ZjGaothu/Electronic-design/readme.md

# 环境舒适度综合测量仪

> 作者: 吴文绪 高子靖
> 
> 日期：2019年7月14日
