ZjGaothu/Electronic-design/miscellaneous/template/log_template.tex

\documentclass[a4paper, 11pt]{article} %option para: draft mode not insert figure, give a faster preview
\usepackage[UTF8]{ctex} %for chinese
\usepackage{amsmath}    %for math
\usepackage{geometry}   %for page setting
\usepackage{graphicx}   % for insert graph
\usepackage{color}    %for link and code color
\usepackage{float}    %for graph table in the follow word
\usepackage[colorlinks,linkcolor=blue,anchorcolor=blue,citecolor=green]{hyperref} %for a linked ref

\setlength{\parindent}{2em} % maybe not use delete it ?
\geometry{left=3.0cm, right=3.0cm, top=3.0cm, bottom=3.0cm}

\graphicspath{{figure/}}

%%%%%%%%%%%%%%%%%%%%%%%%%%%%%%%%%%%%%%%%%%%%%%%%%%%%%%%%%%%%%%%%%%%%%%%%%%%%%%%%%%%%%%%%%%%%%%
%%%%             optional package default in comment to improve compile speed            %%%%

% \usepackage{physics}    %for a readable formulation

% \usepackage[all]{hypcap} % use to jump to the top of figure/table rather than merely caption
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

% \usepackage{wrapfig}  % for picutre on the paragraph right, cannot work with chinese par in pdflatex

% % \usepackage{fontspec} % for other font family

% \usepackage{multirow} %for group row in a table

% % Threeparttable
% \usepackage{threeparttable}
% \usepackage{booktabs}

% % drawing script tikz and Circuitlib 
% \usepackage{tikz}
% \usetikzlibrary{circuits.ee.IEC}
% \usetikzlibrary{positioning}

% \usepackage[american]{circuitikz}

%%%%%%%%%%%%%%%%%%%%%%%%%%%%%%%%%%%%%%%%%%%%%%%%%%%%%%%%%%%%%%%%%%%%%%%%%%%%%%%%%%%%%%%
%%%%%                         new recommand setting area                           %%%%

% % Count those in subsection
% \makeatletter
% \@addtoreset{equation}{subsection}
% \@addtoreset{figure}{subsection}
% \@addtoreset{table}{subsection}
% \makeatother
% \renewcommand {\thefigure} {\thesubsection{}.\arabic{figure}}
% \renewcommand {\thetable} {\thesubsection{}.\arabic{table}}
% \renewcommand {\theequation} {\thesubsection{}.\arabic{equation}}

% \newcommand{\parallelsum}{\mathbin{\!/\mkern-5mu/\!}} % parallesum for resistor
% \newcommand{\upcite}[1]{\textsuperscript{\textsuperscript{\cite{#1}}}}

%%%%%%%%%%%%%%%%%%%%%%%%%%%%%%%%%%%%%%%%%%%%%%%%%%%%%%%%%%%%%%%%%%%%%%%%%%%%%%%%%%%%%%
%%%%%%%%%%%%%%%%%%%%%%%%              for a dairy box%          %%%%%%%%%%%%%%%%%%%%%%

%%%%%%%%%%%%%%%%%%%%%%%%%%%%%%%%%%%%%%%%%%%%%%%%%%%%%%%%%%%%%%%%%%%%%%%%%%%%%%%%%%%%%%%
%%%%%                         introduction section area                           %%%%

\usepackage{xcolor}
\usepackage{framed}

\newlength\sidebar
 \newlength\envrule
 \newlength\envborder
 \setlength\sidebar{1.5mm}
 \setlength\envrule{0.4pt}
 \setlength\envborder{2mm}

\makeatletter
 \long\def\fboxs#1{%
   \leavevmode
   \setbox\@tempboxa\hbox{%
     \color@begingroup
       \kern\fboxsep{#1}\kern\fboxsep
     \color@endgroup}%
   \@frames@x\relax}
 \def\frameboxs{%
   \@ifnextchar(%)
     \@framepicbox{\@ifnextchar[\@frameboxs\fboxs}}
 \def\@frameboxs[#1]{%
   \@ifnextchar[%]
     {\@iframeboxs[#1]}%
     {\@iframeboxs[#1][c]}}
 \long\def\@iframeboxs[#1][#2]#3{%
   \leavevmode
   \@begin@tempboxa\hbox{#3}%
     \setlength\@tempdima{#1}%
     \setbox\@tempboxa\hb@xt@\@tempdima
          {\kern\fboxsep\csname bm@#2\endcsname\kern\fboxsep}%
     \@frames@x{\kern-\fboxrule}%
   \@end@tempboxa}
 \def\@frames@x#1{%
   \@tempdima\fboxrule
   \advance\@tempdima\fboxsep
   \advance\@tempdima\dp\@tempboxa
   \hbox{%
     \lower\@tempdima\hbox{%
       \vbox{%
        \hrule\@height\fboxrule
       %  \hbox{%
        %  \vrule\@width\fboxrule

           #1%
           \vbox{%
             \vskip\fboxsep
             \box\@tempboxa
             \vskip\fboxsep}%
           #1%
           }\vrule\@width\fboxrule}%
         }%\hrule\@height\fboxrule}%
                          % }%
        % }%
 }
 \def\esefcolorbox#1#{\esecolor@fbox{#1}}
 \def\esecolor@fbox#1#2#3{%
   \color@b@x{\fboxsep\z@\color#1{#2}\fboxs}{\color#1{#3}}}
 \makeatother

 \definecolor{exampleborder}{HTML}{00CED1}
 \definecolor{examplebg}{HTML}{CEF6EC}
 \definecolor{statementborder}{rgb}{.9,0,0}
 \definecolor{statementbg}{rgb}{255,255,255}

 \newenvironment{eseframed}{%
   \def\FrameCommand{\fboxrule=\the\sidebar  \fboxsep=\the\envborder%
   \esefcolorbox{exampleborder}{examplebg}}%
   \MakeFramed{\FrameRestore}}%
  {\endMakeFramed}

 \newcounter{diary}
\renewcommand{\thediary}{\arabic{diary}}

 %%% CODE ENVIRONMENT. PUT TEXT INTO COLORED FRAME %%%
 \newenvironment{diary}[2]
 {\par\medskip\refstepcounter{diary}%
 \hbox{%
 \fboxsep=\the\sidebar\hspace{-\envborder}\hspace{-0.5\sidebar}%
 \colorbox{exampleborder}{%
 \hspace{\envborder}\footnotesize\sffamily\bfseries%
 \textcolor{black}{{#1}\ {#2}\enspace\hspace{\envborder}}
%\today
 }
 }
 \nointerlineskip\vspace{-\topsep}%
 \begin{eseframed}\noindent\ignorespaces%
 }
 {\end{eseframed}\vspace{-\baselineskip}\medskip}

\begin{document}

\begin{diary}{}{2019.07.01上午}
      balbabla
    \begin{equation}
        math
    \end{equation}
      \begin{figure}[H]
          \centering
          
          \caption{title}
      \end{figure}
        \begin{table}[H]
    \centering
      \begin{tabular}{cc}
          A & a\\
          BBB & b\\
      \end{tabular}
    \caption{test}
  \end{table}

  \begin{lstlisting}[caption = c++ hellow world]
#include<iostream>
int main() {
    int a;
    for (int i = 0; i < 100; i++) {
      if (i % 2 == 0) {
        printf("Hello World!");
      }
    }
  return 0;
}
\end{lstlisting}
\end{diary}

\end{document}
