ZjGaothu/Electronic-design/report/final_report/PDFsam_merge.pdf

# 电子技术设计 环境舒适度综合测量仪 预习报告

班级: 自 72 | 自 72
姓名： 高子靖 | 吴文绪
学号: 2017010917 2017010910

目录

1 选题背景及课题简介 | 1
2 方案比较与选择 | 3
3 基于 WEBENCH 的电源电路仿真 | 10
4 电路框图 | 14
5 数字系统流程图 | 15
参考文献 | 17
A WEBENCH 生成的仿真报告 | 18

1 选题背景及课题简介

## 1 选题背景及课题简介

### 1.1 选题背景

随着我国经济不断发展，人民生活水平不断提高，人们对于室内生活环境的要求越来 越高。另一方面，受到学科交叉的影响，以往的室内设计流程从较为主观的审美经验导向 型，转向参考光学、心理学、生物学等学科知识的综合性设计。而迈向这样的设计，不免 要进行一定的实验，标定室内环境参数是如何影响被试者对环境的评价的。 在传统的实验中 [1]，主要的流程是设置合适的室内环境，保证被试者进入实验后的 几个小时待测参量基本不变（如使用空调控制室内温度，用灯光配合壁纸控制室内光强）， 当实验结束后，需要被试者根据这段时间的体验（如被试在环境中自习的专注度），回忆 并填写相关问卷。可以看到，整套实验中，设置参数稳定的环境需要大量的前期准备，并 且结束后的问卷统计环节有一定的主观性且效率较低。这些流程，均存在使用电子系统进 行自动化的空间。
另外一方面，人们对于环境质量的要求体现在对 PM2.5（当量直径等于或小于 2.5 微 米的颗粒物体又被称为细颗粒、细粒、可入肺颗粒物）等指标的关注上。以 PM2.5 为例， 它易悬浮在空气中，当被人体吸入肺部后易进入肺泡且沉积时间长，会对人的眼睛、鼻腔、 上呼吸道等造成直接的伤害，也可能可导致心脏病或心血管疾病。正是这些健康敏感问题 直接催生了 PM2.5 检测仪和其他家用空气质量测量仪等电子产品的出现。广阔的市场为 我们提供了丰富的已有设计方案作为对比参考，能让我们在前人的基础上综合优点、补足 缺陷，继续进步，完成对环境参数的集成测量。
此外，作为一个应用于室内环境试验的测量仪，我们还将被试者评价环境这一环节整 合了进来。在这个系统中，我们面向的是专注度环境测试，被试者常接到的任务是在待测 环境中自习，评价自己的自习专注度。我们注意到，自习时的不专注可以抽象为人的上半 身离开桌面的正上方，这样的现象的检测可以通过红外传感器或微波雷达这样的生物检测 模块实现。使用了这样的方法后，一方面我们将主观的问卷评价进行了指标化和客观化， 另一方面，电子系统采集统计数据免去了统计问卷的过程，让整个实验更为自动化。在与 实际环境问题结合也是我们与“智能检测”主题相关的出发点。

### 1.2 课题简介

我们以 PM2.5 检测仪作为出发点，进而加入对空气湿度，温度，气压及其他有害气 体的检测等作为指标，集成为一款环境舒适度综合测量仪，并通过蓝牙模块与手机进行连 接，能够传输一份格式化的环境检测报告到用户的手机中去，以及 LCD 进行显示。

### 1.2.1 测量指标

本课题围绕“智能检测”的主题，拟在设计中加入对以下指标的检测：

- 大气 PM2.5 颗粒浓度
- 空气湿度，也即湿蒸汽中液态水分的质量占蒸汽总质量的百分比

1 选题背景及课题简介

- 环境温度，温度对人体对环境舒适度的感知造成直接的影响
- 大气压强，环境的气压会对人体生理以及心理产生影响

以上我们初步计划进行测量的指标，并对相应的测量数据进行存储与发送。通过以上 的四个指标能够初步反映所处环境的基本状况，包含健康指标和舒适指标，提供给用户后 用户可根据相应的测量结果对湿度，温度等进行调节或做好大气污染的相应防护措施，从 而提高环境的舒适度。

### 1.2.2 实现方法

我们在简介部分只给出实现方案的基本框图，具体的实现方案细节将于第2部分中给 出。那么电路框图如下图 [1] 所示：

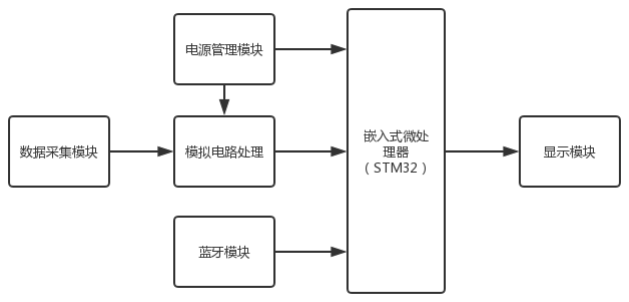
[picture p1: figure]

图 1: 设计总体框图

由上图可知，我们通过传感器进行数据采集，进一步进行模拟电路对数据处理，再通 过模数转换电路驱动单片机，除此之外由电源管理模块为单片机以及模拟部分提供稳压电 源，并另行有蓝牙模块与手机进行通讯，而数字部分的处理全部交由 STM32 完成，最终 进行显示。

### 1.2.3 结果反馈方法

我们计划使用 LED 或 LCD 显示屏将收集到的数据进行显示，显示内容包括以上叙 述的测量指标，时间日期等，并加入阈值报警，若超过规定的阈值，则通过蜂鸣器进行报 警。其次利用蓝牙模块与手机进行连接，将测量结果可以在用户手机上进行实时的显示， 能够极其方便的获取当前环境情况。

2 方案比较与选择

## 2 方案比较与选择

通过我们对文献的查阅以及阅读，可以看到大多数基于单片机的大气环境检测系统， 都是选择一款合适的单片机或其他微处理器作为主控，也即系统的核心，通过各个传感器 与主控的连接进行数据的处理，最后通过 LCD 显示屏来进行结果的反馈。在整体上这些 方案大同小异，但为我们的设计提供了思路与基础，而方案的选择也体现在细节方面的主 控芯片的选择以及传感器的选择。

### 2.1 文献方案叙述

首先叙述总结在文献中获得的方案设计，为了比较不同，我选择了其中的一篇基于 ARM 的多功能环境检测系统与基于 STC90C51 单片机的多功能检测系统分别进行介绍。

### 2.1.1 基于 ARM 的多功能环境检测系统

首先我查阅到 ARM 处理器是英国 Acorn 有限公司设计的低功耗成本的第一款 RISC 微处理器。具有体积小、低功耗、低成本、高性能等优势。而在文章¹的设计中以 ARM 作 为主控单元，还包括 PM2.5 传感器单元、温湿度传感器单元、液晶显示屏单元、语音实时 播报单元、外部事件触发单元 [2]。整体可以由如下的框图实现：

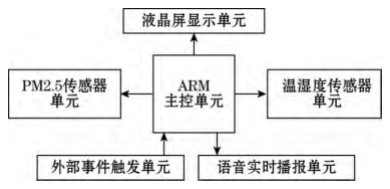
[picture p2: figure]

图 2: ARM 设计总体框图

主控单元与模块化的思路是对于类似系统设计的基本思路，也是我们阅读的文献的共 同思路，而其他传感单元由于可替换性因此需要我们加以选择。 首先主控单元采用了 ARM，可使用 KEIL4 编译软件环境进行开发，同时可利用 C 语言进行程序的编写，开发时十分方便快捷。
PM2.5 浓度传感器其采用 PMS70XX 系列超薄数字式通用颗粒物浓度传感器。经查 阅其中文手册，得知该传感器工作原理图如下所示：

1引用文章，见于参考文献 1 中

2 方案比较与选择

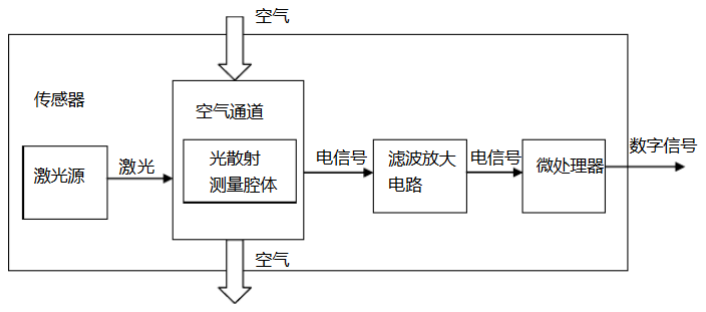
[picture p3: figure]

图 3: PM570XX 系列传感器

其主要通过激光源发射激光经过腔体，在腔体内由于颗粒物浓度不同导致散射光强不 同，进而能够转化为电信号，从而利用反射光强来反馈出细微颗粒物的浓度，直流供电电 压为 5V，最大工作电流为 100mA，工作温度范围为 −20◦C ∼ 50◦C, 传输协议为默认波 特率 9600Kbps，无校验位，有一位停止位。
液晶显示屏采用一个 3.5 英寸的 TFT LCD 液晶屏，320×240 像素，26 万色，支持触 摸屏功能，能够较好的进行显示。其他单元模块芯片不再赘述。

### 2.1.2 基于 STC90C51 的检测系统

该检测系统为我所阅读文献中另一篇较具有代表性的文献，其设计除主控单元不同 外，在传感器的选取上也与上一个单元有所不同，因此特此拿来与上一个系统进行比较分 析，同样首先从整体框图上说明该系统的工作原理。

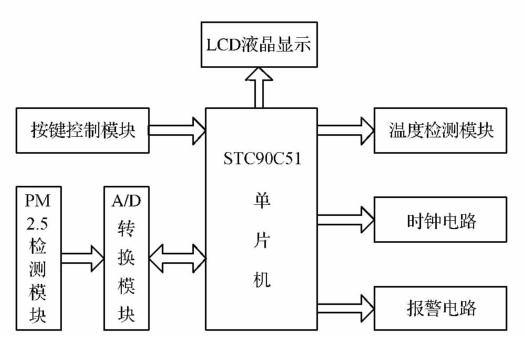
[picture p4: figure]

图 4: STC90C51 总体框图

可见该系统总体框图与 ARM 系统基本相似，均以单片机作为主控单元，各模块电路 通过硬件连接与主控单元进行相连与交互，只是该系统的设计中外接部分单元电路的功能 不同。

2 方案比较与选择

其主控单元为 STC90C51 单片机，为一款高速低功耗单片机，其在编译环境以及编程 的方便性与可移植性等方面与其他单片机并无较大差别，因此也非选择的重点。
其 PM2.5 检测模块使用的传感器为 GP2Y1050AU0F 灰尘传感器，是夏普公司开发 的二代 PM2. 5 传感器 [4]，输出电压在 0 ∼ 3.5V 的范围内，电流损耗最大为 20mA。在 无尘时输出电压为 0V，其原理如下图 [5] 所示：

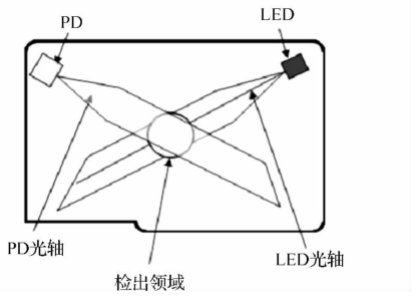
[picture p5: figure]

图 5: GP2Y1050AU0F 灰尘传感器结构

检测原理为灰尘或烟雾颗粒通过防尘通气孔进入装置，红外发光二极管发射红外线到 颗粒物上，光敏三极管接收其散射光信号。可见其原理与 PM570XX 系列相似，第二代 PM2. 5 传感器能随使用时间的增长自动计算和优化损耗 [3]，能够在较长时间的使用后保 证输出数据的准确性，相对而言体现了此传感器的优势。
在此设计中采用 ADS7822 进行模数转换，其输入与传感器的模拟输出相连, 作用是将 传感器输出的模拟电压信号经过 A/D 转换，再由单片机数据采集、计算、处理。ADS7822 是 TI 公司的低功耗，高性能 12 位 A/D 转换芯片，正常模式下典型功耗为 0.54mW。 其使用的温度模块采用了 DS18B20 数字温度传感器，其具 9 Bit 至 12Bit 的摄氏温 度测量精度，测量范围为-55∼ +125◦C, 可以直接由数据线进行供电而不需要外部电源，因 此可以外部电源的使用。
综上所述介绍的两种具有多功能的 PM2.5 检测仪，为我们的设计提供了基本的思路 与选择的方向，我们旨在设计出具有更多功能的环境舒适度测量仪，以上 pm2.5 的多功能 模块的总体方案为我们的设计的重要部分，接下来我将继续介绍我们的整体方案选择。

### 2.2 方案选择

综合考虑我们选用 Arduino 单片机作为主控模块，其余相应单元模块进行了芯片的初 步选择，这既考虑到芯片供电电压的选取与我们电源管理电路模块尽量相符，又兼并考虑 了芯片的精度，工作范围等条件，下面依次介绍我们所选取的芯片，电路框图类比于以上 两种设计，我们的设计如下：

2 方案比较与选择

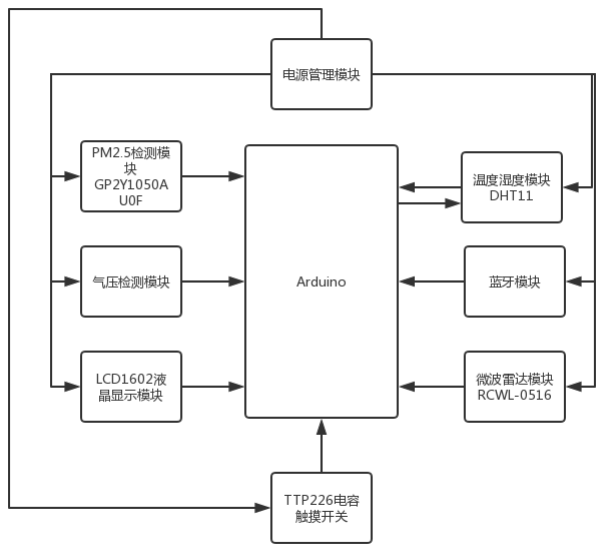
[picture p6: figure]

图 6: 简略框图

### 2.2.1 单片机 Arduino

Arduino 就是主要以以 AVR 单片机为核心控制器的单片机应用开发板, 其开发人员 开发了简单的函数，还有许多应用库，这样就不用直接去操作寄存器。Arduino 相对于传 统的单片机而言，可以不用去了解去硬件的知识去进行开发，并且利用 C 语言进行开发， 指令的可读性更强，Arduino 还有很多第三方库，包含了写好的函数，每个函数有各自的 功能，可供调用。常用的库有标准链接库，通信库，传感器库，音效和声波库，电机和脉 宽调制库，计时器库，实用工具库等。因此我们选择 Arduino 作为主控模块。

### 2.2.2 GP2Y1050AU0F 灰尘传感器

我们使用该传感器作为 PM2.5 检测模块的核心部分，GP2Y1050AU0F 灰尘传感器为 夏普公司的二代 PM2.5 传感器，主要功能为烟灰或室内灰尘等空气中的粉尘处于检测范 围内时，由于这些粉尘而散射的光射入光接收元件作为电压输出。传感器的一般性能如下 表 [1] 所示：

表 1: 绝对最大额度
项目 | 记号 | 额定 | 单位
动作电压 | Vcc | 4.8 ∼ 5.2 | V
动作温度 | Topr | −10 ∼ +65 | ◦C
保存温度 | Tstg | −20 ∼ +80 | ◦C

2 方案比较与选择

其电气的光学特性如下表 [2] 所示:

表 2: 电气的光学特性
项目 | 记号 | MIN | MAX | 单位
检测感度 | K | 0.35 | 0.65 | V/(0.1mg/m³
)
电流 | Icc | ——— | 20 | mA

其中的检测感度 K 为关于粉尘浓度 (0.1mg/m³
) 变化时的输出电压变化量所规定的。
其输出方式有模拟端口和串口两种方式，其中模拟端口输出电压 Vo 乘以系数 K 得到灰尘 浓度值，单位为 µg/m³
, 串口输出经通信转换后得到 Vo 值，传输特性如下所示：

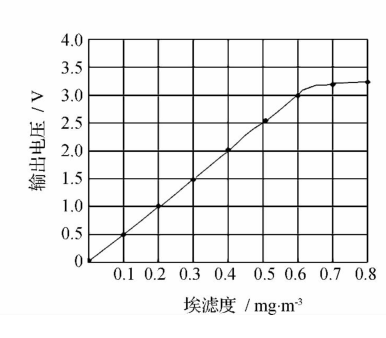
[picture p7: figure]

图 7: 输出特性曲线

### 2.2.3 DHT-11 温度湿度传感器

DHT11 数字温湿度传感器是一款含义已校准数字信号输出的温湿度复合传感器。其 中的传感器包括一个电容式感湿元件和一个 NTC 测温元件，并和一个高性能 8 位单片机 直接相连，可以应用于除湿器、农业、冷链仓库等方面，而这里我们使用其作为环境检测 的温湿度模块，由于其数字信号输出的特性，能够方便的与单片机相连，并且将精确校准 的信号交由单片机进行处理。因此我们选用 DHT-11 模块。传感器的外形尺寸如下图 [8] 所示

2 方案比较与选择

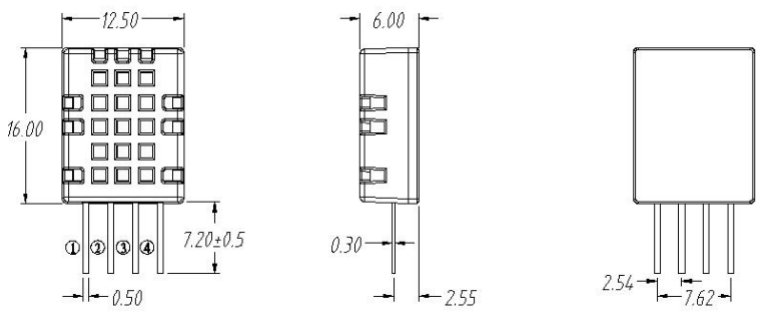
[picture p8: figure]

图 8: DHT11 外形尺寸

其中的引脚为：1.VDD 供电为 3.3 ∼ 5V DC，2.DATA 串行数据，单总线 3.NC 空脚 4.GND 接地，电源负极。
湿度的量程范围为 5 ∼ 95%RH, 温度的量程范围为 −20 ∼ 60◦C。而在 25◦C 的条件 下，相对湿度的精度为 ±5%RH, 温度的精度为 ±2

◦C, 电气特性如下表 [3] 所示：

表 3: 电气特性
参数 | 条件 | MIN | type | max | 单位
供电电压 | | 3.3 | 5.0 | 5.5 | V
供电电流 | | 0.06 | | 1.0 | mA
采用周期 | 测量 | | >2 | | S/次

### 2.2.4 LCD1602 液晶显示屏

LCD1602 是一种工业字符型液晶，能够同时显示 16x02 即 32 个字符。LCD1602 液 晶显示的原理是利用液晶的物理特性，通过电压对其显示区域进行控制，即可以显示出图 形。其引脚功能在此不再赘述，外形如下所示：

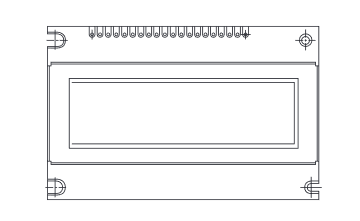
[picture p9: figure]

图 9: DHT11 外形尺寸

该模块的电气特性如下表所示：

2 方案比较与选择

表 4: 电气特性
参数 | 条件 | MIN | type | max | 单位
输入电压 | VDD=+5V | 4.5 | 5.0 | 5.5 | V
输入电流 | VDD=5V | 1.0 | 1.4 | mA

### 2.2.5 TTP226 电容触摸开关

TTP226 是一款接触板检测 IC，提供 8 个接触键。低功耗和宽工作电压是接触键在 DC 或 AC 应用中的特点。其工作特性如下所示：
工作电压为 2.0∼5.5V, 工作电流在 VDD=3v 时典型值 80µA, 最大值 160µA, 输出刷 新率在 VDD=3v 时约 55Hz。

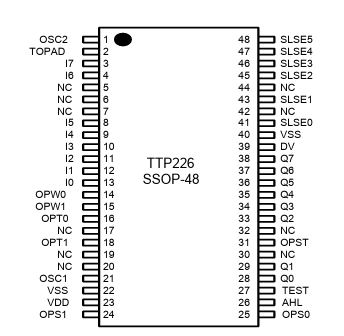
[picture p10: figure]

图 10: TTP226 封装引脚图

其应用为取代传统的按键，由于我们使用的液晶显示屏一次性显示字符有限，因此在 本设计中借助于此 IC 来进行不同检测指标的选择显示。

### 2.2.6 RCWL-0516 微波雷达

RCWL-0516 微波雷达采用多普勒雷达技术，是专门检测物体移动的微波感应的模块。 具有灵敏度高，感应距离远，可靠性强、可以穿越障碍物进行检测的特点，这里我们基于 设计出发时将环境舒适度以学生自习作为标准，因此会对环境内的人体姿态例如抖腿、玩 手机等动作进行捕捉，希望借助此模块来探测人手是否静放于桌面上，或室内其他人是否 有抖腿的行为，将由此模块进行捕捉。
此模块外观如下所示：

3 基于 WEBENCH 的电源电路仿真

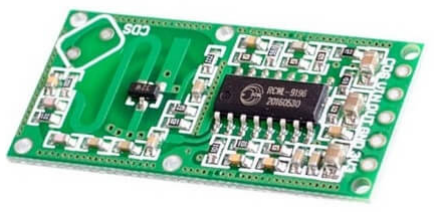
[picture p11: figure]

图 11: RCWL-0516 外观图

其中部分引脚的名称与管脚定义的对应关系如下：

表 5: 管脚对应关系
名称 | MIN | type | max | 单位
工作电压 | 4 | | 28 | V
工作电流 | | 2.8 | 3 | mA
探测距离 | 5 | 7 | 9 | M
输出电压 | 3.2 | 3.3 | 3.4 | V

部分性能参数如下：

表 6: 性能参数
名称 | 管脚定义
3V3 | 3V3 电源输出
GND | 地
OUT | 控制输出，检测到有移动物体输出高电平
VIN | 输入电压 4-28V
CDS | 使能控制芯片，低于 0.7V，OUT 一直输出低电平

## 3 基于 WEBENCH 的电源电路仿真

电路使用标称值为 9V 的锂电池作为电源。对于主控模块 arduino 其板载有稳压模块， 对于 7 − 12V 范围内波动的电压，均能正常工作。故而电源管理电路主要给外围的各类 传感器使用。查看前述各传感器模块的工作电压范围，电源管理电路仅做 5V 输出即可。 将各模块的工作电流最大值进行求和得到的电流 IΣ ≈ 300mA。考虑后续可能增加其他模 块和安全工作余量的考虑，在设计电源时取 Io(max) = 1.5A。标称值为 9V 的锂电池，通 过官方数据手册得到其输出电流波动范围大约为 8 ∼ 10V ，以此作为 Vin 的范围，输入 WEBENCH 后，在所给仿真方案中挑选了基于 TPSM84205EAB 的电源管理电路方案。 其生成的详细报告在附录A中给出，这里主要摘取其关键的参数和补充的仿真进行分析。 此外，在 WEBENCH 生成的这个方案中，不支持波特图仿真和热仿真。故而从其他 波形图验证设计合理性的流程中，我们应当保证一定的余量。具体而言是在稳态波形中，

3 基于 WEBENCH 的电源电路仿真

输出电压的波动应当足够小，从另一方面达成用波特图验证自激振荡不会发生的目的；在 所有波形中，各极限指标应当与阈值有一定的差距，保证在环境温度变化时，电路各输出 参数仍满足要求。

### 3.1 软启动仿真

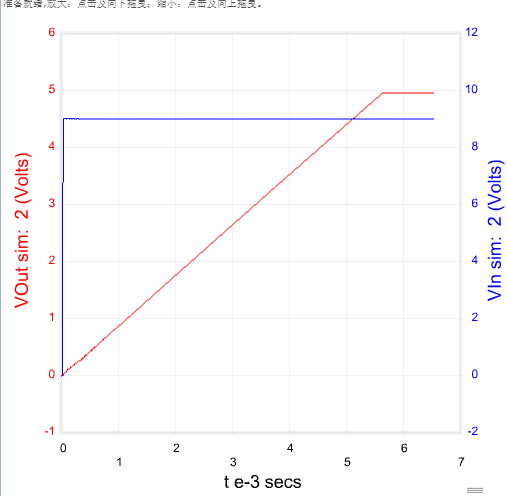
[picture p12: figure]

图 12: Vin, Vout 软启动仿真波形

可以看到，为了消除自激振荡而在输入输出端的增加的两个电容，让 Vout 的变化减 慢了，在开关合闸后，需要一定的时间给两电容充电，并且等到芯片内部的稳压管和放大 模块建立合理的直流电压值后，Vout 才在设定工作范围下工作。从图中具体读得在大约 5.5ms 后 Vout 稳定，电路开始正常工作。
从应用背景，我们可以推测整体系统在工作后不常断电，故虽减小电容容值可以减小 合闸后的转换时间，但是会减小自激振荡的幅度裕度，在这两个参数指标的取舍上，结合 实际应用背景和可得的电容，我们使用了原来的容值设置，Cin = 10µF, Cout = 47µF。

3 基于 WEBENCH 的电源电路仿真

### 3.2 稳态仿真

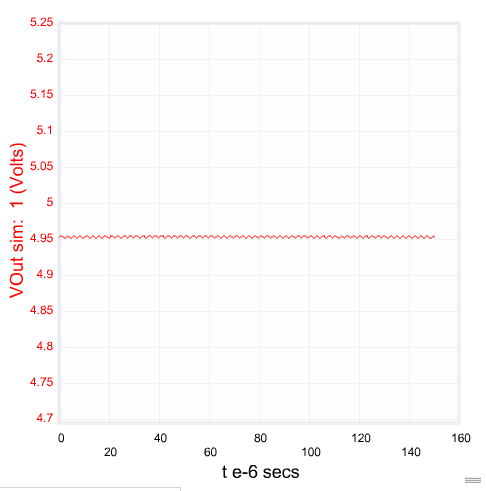
[picture p13: figure]

图 13: Vin, Vout 稳态仿真波形

稳态仿真中，我们可以看到输出电压的纹波情况。由于使用的是线性稳压电路而非开 关稳压电路，故在稳态时，没有其他工作状态随时间有明显变化的元件，仿真波形仅做排 除稳压器自激振荡的可能性和电路工作状态合理稳定的验证。

### 3.3 输入瞬态响应仿真

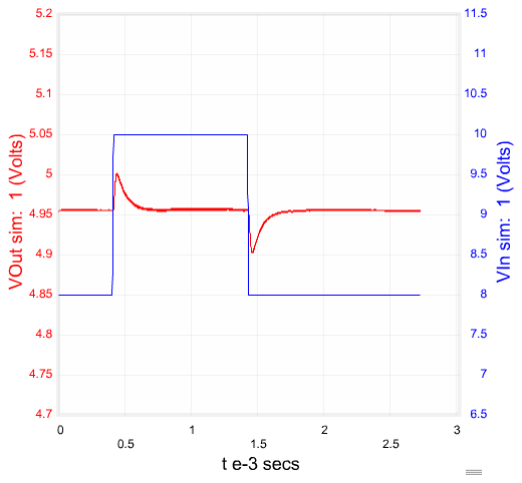
[picture p14: figure]

图 14: Vin, Vout 输入瞬态仿真波形

输入瞬态响应中，在保证稳态的情况下，Vin 从最小值 8V 跳变到允许最大值 10V 再 回跳。从波形中可以知道，在电压变化后且达到稳态时，Vout 几乎不变，符合电源电路的 一大要求——输出电压几乎不随输入电压的变化而变化。之后再观察转换暂态，可以看到 输出变动量的峰值和谷值约为 0.05V ，变化较小，且在供电设备（即各传感器模块）的允

3 基于 WEBENCH 的电源电路仿真

许工作电压范围内，设计符合要求。

### 3.4 负载瞬态响应仿真

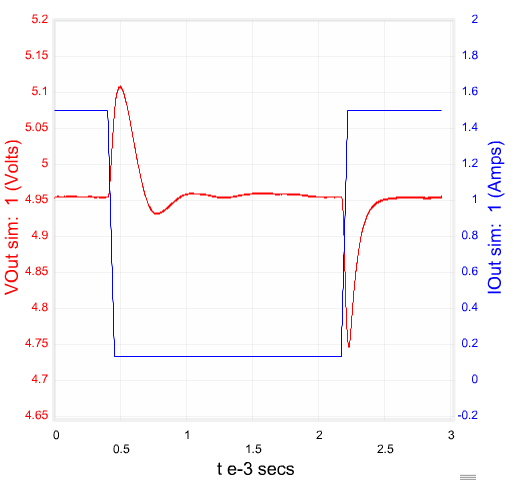
[picture p15: figure]

图 15: Vin, Vout 负载瞬态仿真波形

负载瞬态响应中，在保证稳态的情况下，IL 从最大值 1.5A 跳变到允许最大值 0.15A 再回跳。从波形中可以知道，在电压变化后且达到稳态时，Vout 几乎不变，符合电源电路 的另一大要求——输出电压不随合理变化范围内的负载变动而变化。之后再观察转换暂态， 可以看到输出变动量的峰值和谷值约为 0.2V ，相对于上一节中的输入瞬态响应，负载变 化响应的变化较大，可能存在一定的危险。
在设备工作时，电路各传感器处于常开状态，不会产生明显的负载变化，在进行通信 时，由于无线收发的存在，会产生较大的负载变动，导致输出电压的变化。电压变动大会 比较明显影响模拟量传感器的测量精度，让变动时期测得的数据变得不可靠。可能考虑到 这一点，我们在选取通信模块时，选用 3.3V 的低功耗模块，并作为 arduino 的负载而非电 源管理电路的负载，合理规避了负载变化导致的较为明显的电源输出电压变化的可能性。

4 电路框图

### 3.5 电源效率和纹波电压

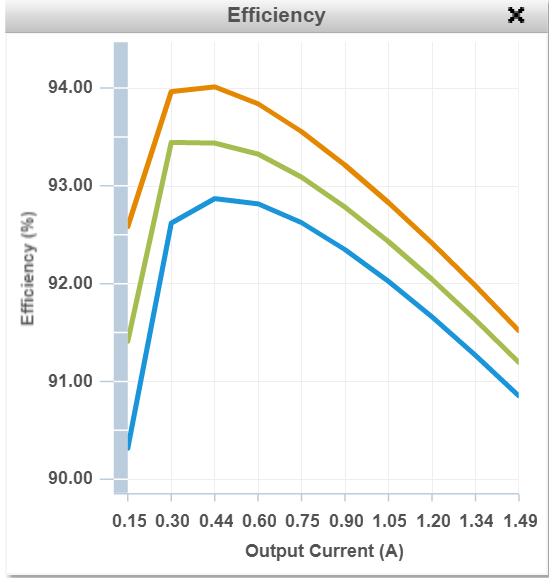
[picture p16: figure]
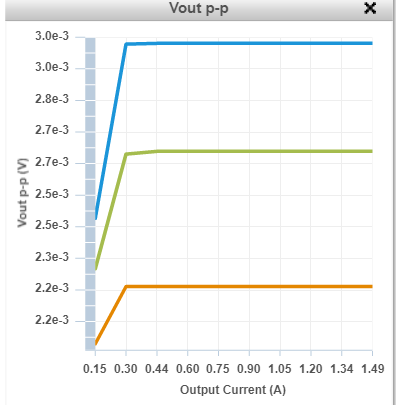
[picture p17: figure]

图 16: η ∼ Iout 的变化关系 | 图 17: ∆V ∼ Iout 的变化关系

上图中的橙色线为 Vin = 8.0V ，绿色线为 Vin = 9.0V ，蓝色线为 Vin = 10.0V 时的输 出情况。可以看到在合理的工作电流变化范围内，η > 90% 且在目前设计的典型负载电流 I = 0.3A 的情况下，大约能得到最高的电源效率。纹波电压随 Iout 的变化较小，并且纹波 电压本身的值较小，说明电源管理电路输出的电压在大范围内符合好的“直流电压”的要 求。

## 4 电路框图

此电路框图类比于第二部分的文献中框图，以 Arduino 为核心主控单元，其余各部分 功能电路模拟输出或数字输出均接入 Arduino 中进行数据的处理与存储，其中各个部分单 元用到的芯片的简介均在第二部分给出，因此各部分功能在此简要叙述：

- 电源管理模块输出 5V 电压为整个系统进行供电
- PM2.5 模块负责检测大气细微颗粒物
- 气压检测模块检测大气压强是否在舒适范围内
- TTP226 电容触摸开关进行显示屏的显示内容选择与切换
- 蓝牙模块负责与手机通信，将结果反馈至手机
- 微波雷达模块负责监视室内人体姿态情况，是否满足“舒适”条件
- LCD1602 负责结果的直接显示，通过液晶显示屏获取测量结果

而最终的框图相较于第一部分有所改进与补充，并修改 STM32 为 Arduino，如下图
[18] 所示:

5 数字系统流程图

图 18: 简略框图

## 5 数字系统流程图

整体而言，数字系统主要实现以下几个功能:

- 对于不同传感器的巡检管理。系统涉及的传感器较多、IO 口较少且不需要同步检测， 故而采用巡检这样的外围控制模式。
- 对于传感器和 DA 转换模块最后发来的数字量做一定的预处理或者说数字滤波。在 不同的实验设置下，实验者关心的时间跨度，参量阈值不尽相同，这些参数的变化通 过数字系统对前端信号预处理流程的不同得以实现。
- 对于键盘输入的响应管理，用于切换仪器的测量模式，显示不同的测量。
- 对于实验数据的同步，用于驱动通信模块，回传实验数据用以分析。

对于这几大功能，结合实际测量过程，得到数字系统的流程图如下：

5 数字系统流程图

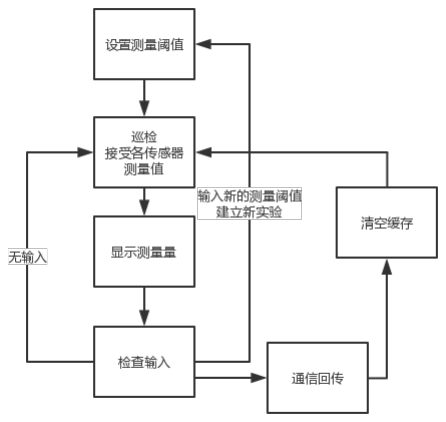
[picture p18: figure]

图 19: 数字系统流程图

参考文献

## 参考文献

[1] 试论人性化设计在室内环境艺术设计中的应用. 建材与装饰, 560(51):62–63, 2018.
[2] 曲爱玲，马长路. 基于 arm 的多功能环境检测系统. 仪表技术与传感器, (9):91–93, 2017.
[3] 王路，曲伟，胡家骏. 多功能 pm2.5 检测系统. 黑龙江大学工程学报, 7(1):66–72, 2016.
[4] 陈卓. 一种 pm2.5 检测系统的设计与实现. 数字技术与应用, (11):143–144, 2016.

## A WEBENCH 生成的仿真报告

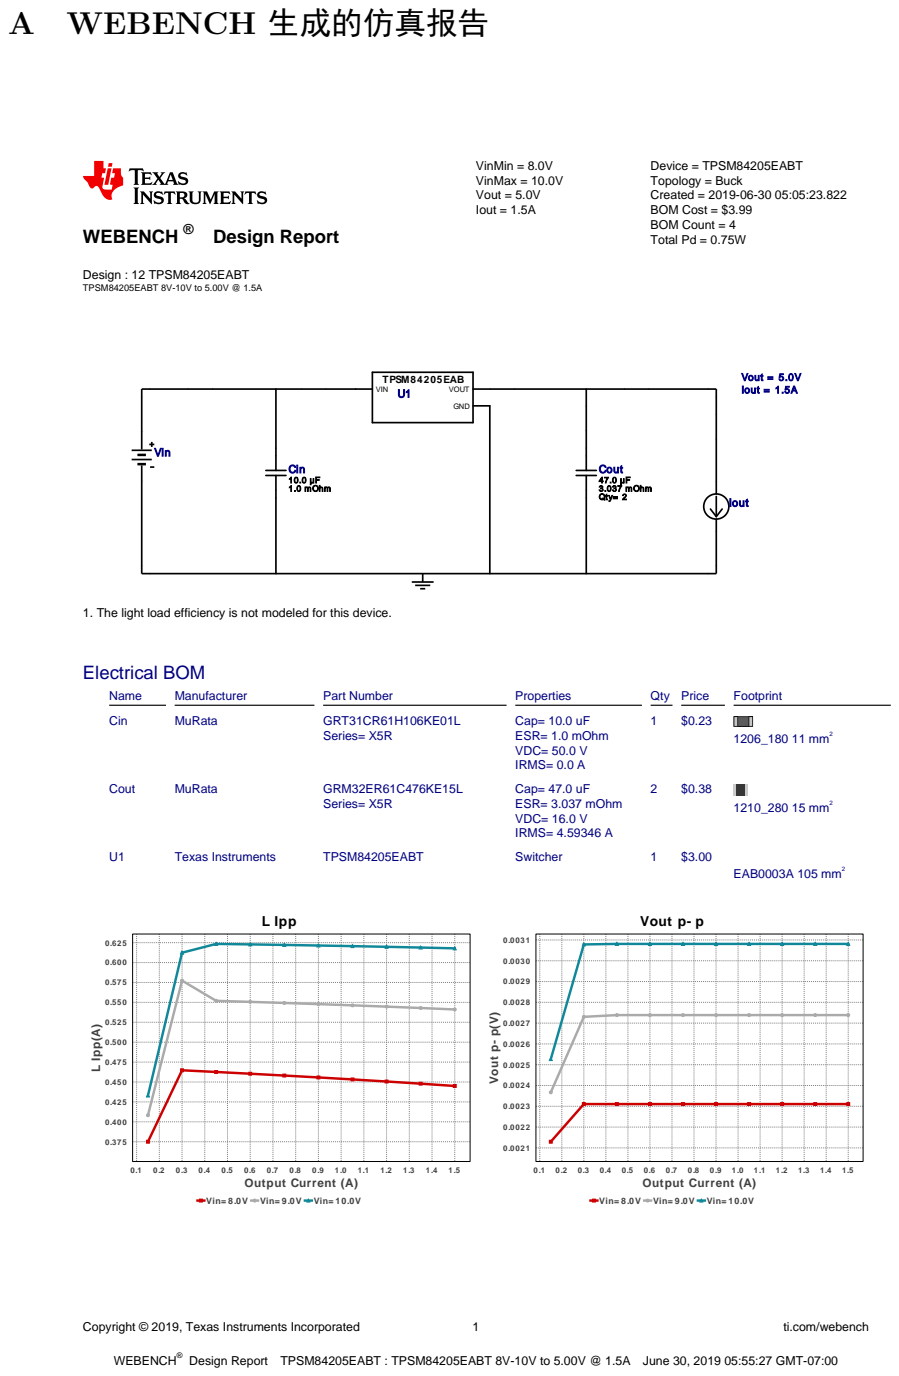
[picture p19: page 20]
Copyright © 2019, Texas Instruments Incorporated; ti.com/webench; WEBENCH®; Design : 12 TPSM84205EABT TPSM84205EABT 8V-10V to 5.00V @ 1.5A; VinMin = 8.0V VinMax = 10.0V Vout = 5.0V Iout = 1.5A; Device = TPSM84205EABT Topology = Buck Created = 2019-06-30 05:05:23.822 BOM Cost = $3.99 BOM Count = 4 Total Pd = 0.75W; Cin 10.0 µF 1.0 mOhm; Cout 47.0 µF 3.037 mOhm Qty= 2; TPSM84205EAB VIN; GND; VOUT U1; Vout = 5.0V Iout = 1.5A; Iout; Vin; Electrical BOM; Name; Manufacturer; Part Number; Properties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

WEBENCH ® Design Report

1. The light load efficiency is not modeled for this device.

Vin= 8.0V Vin= 9.0V Vin= 10.0V

Design Report TPSM84205EABT : TPSM84205EABT 8V-10V to 5.00V @ 1.5A June 30, 2019 05:55:27 GMT-07:00

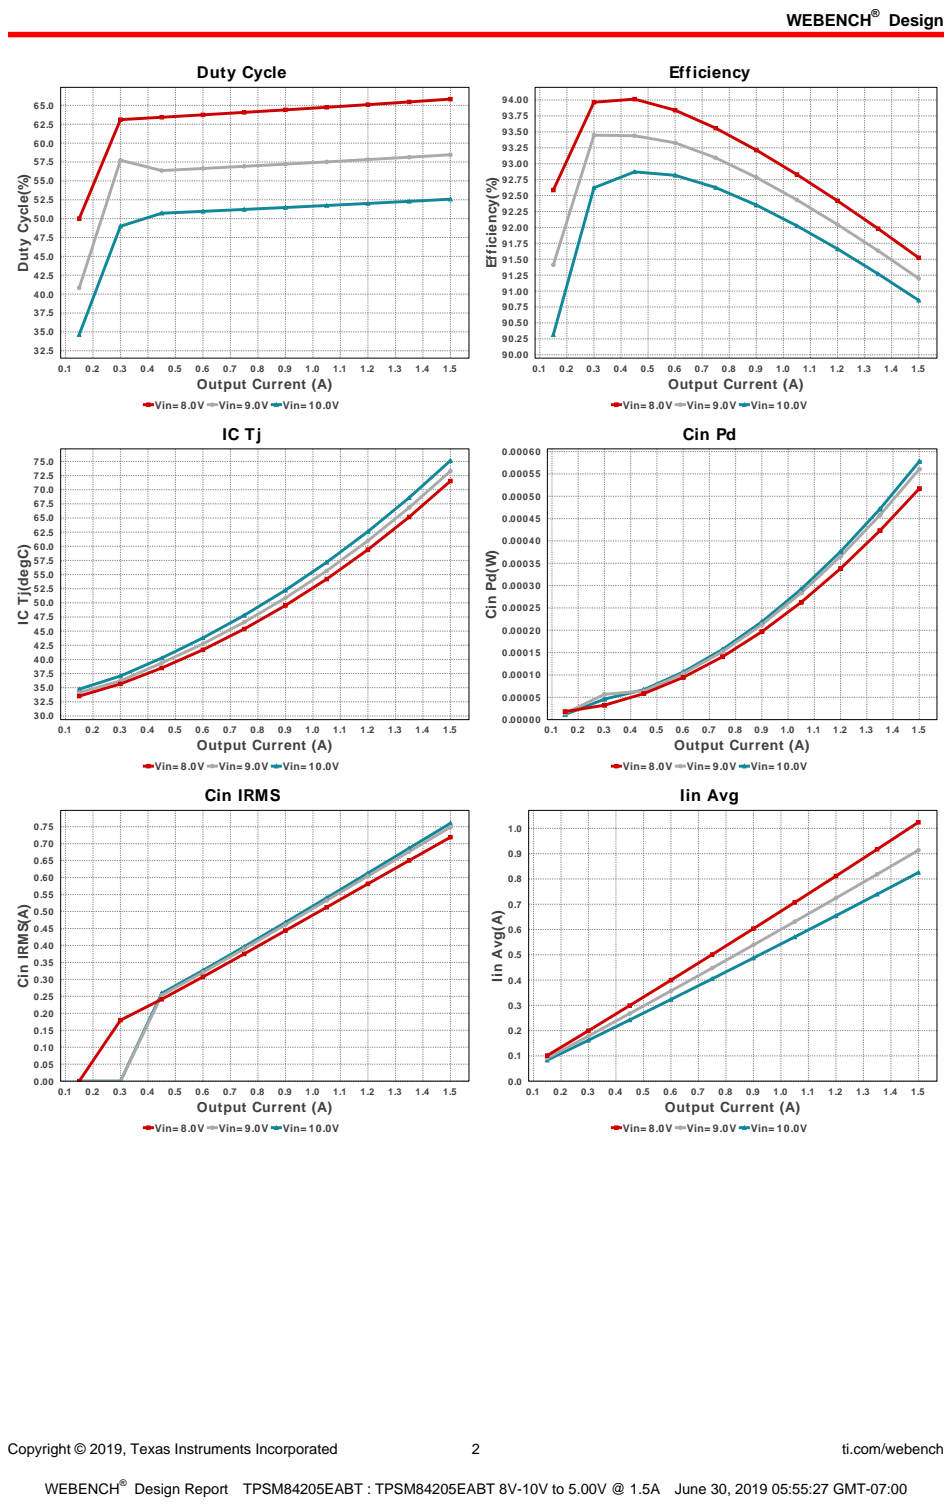
[picture p20: page 21]
WEBENCH®; Design; Copyright © 2019, Texas Instruments Incorporated; ti.com/webench; Duty Cycle; 1.5 Output Current (A); Duty Cycle(%); Efficiency; Efficiency(%); Cin Pd; 0.1 0.2 0.3 0.4 0.5 0.6 0.7 0.8 0.9 1.0 1.1 1.2 1.3 1.4 1.5 Output Current (A); Cin Pd(W); Cin IRMS(A); Iin Avg(A)

Vin= 8.0V Vin= 9.0V Vin= 10.0V

IC Tj(degC)

Cin IRMS

Iin Avg

Design Report TPSM84205EABT : TPSM84205EABT 8V-10V to 5.00V @ 1.5A June 30, 2019 05:55:27 GMT-07:00

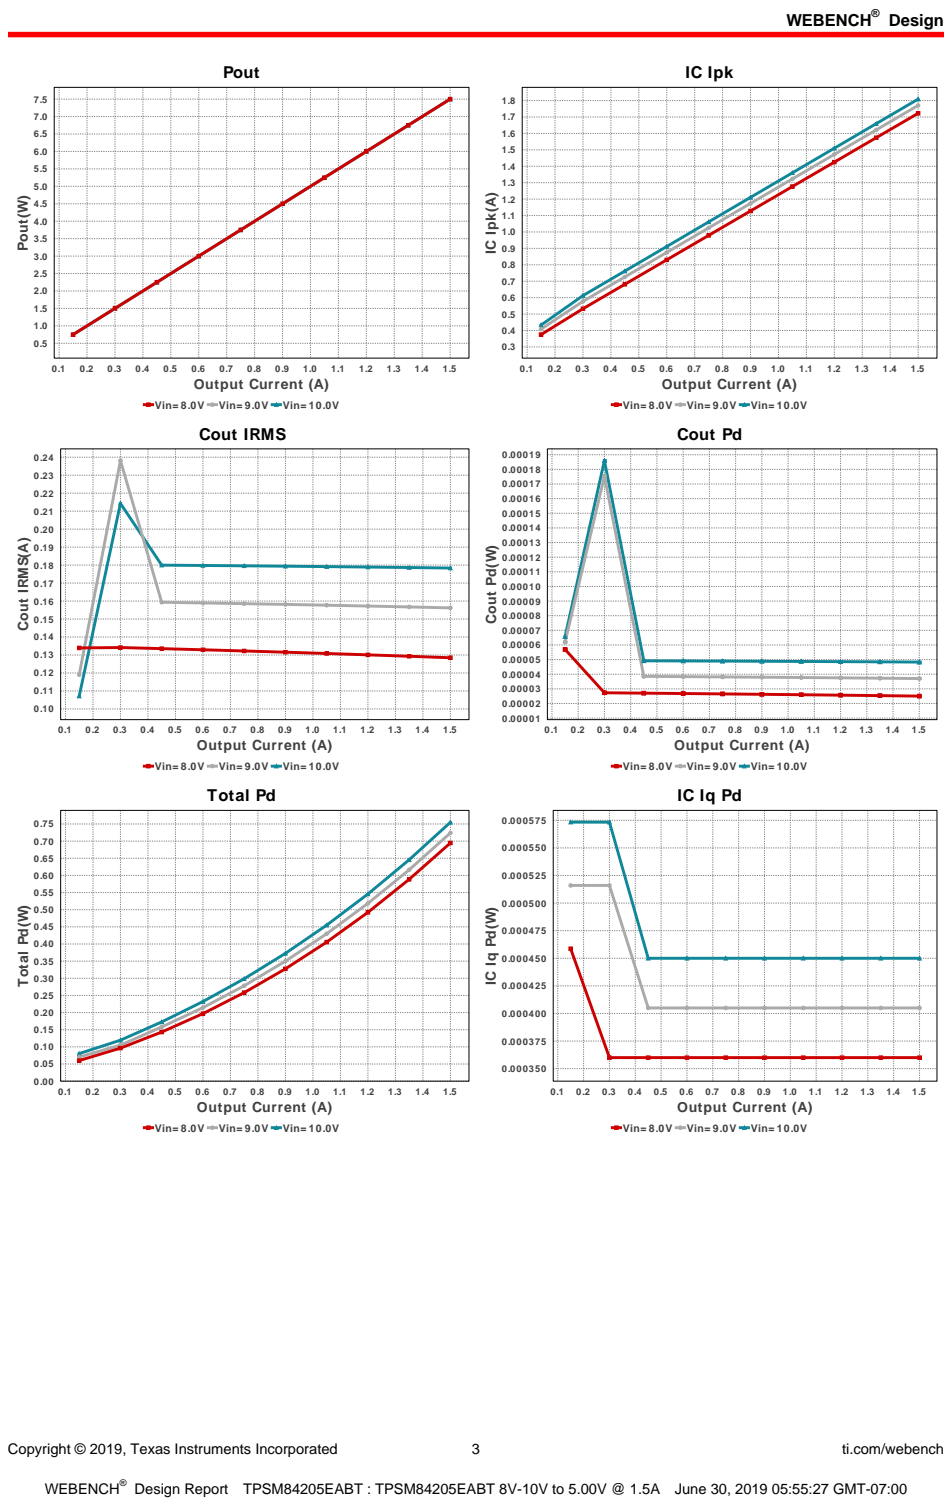
[picture p21: page 22]
WEBENCH®; Design; Copyright © 2019, Texas Instruments Incorporated; ti.com/webench; Pout; 1.5 Output Current (A); Pout(W); IC Ipk; IC Ipk(A); Cout IRMS(A); 0.1 0.2 0.3 0.4 0.5 0.6 0.7 0.8 0.9 1.0 1.1 1.2 1.3 1.4 1.5 Output Current (A); Cout Pd(W); Total Pd(W)

Vin= 8.0V Vin= 9.0V Vin= 10.0V
Cout IRMS

Cout Pd

Total Pd

Design Report TPSM84205EABT : TPSM84205EABT 8V-10V to 5.00V @ 1.5A June 30, 2019 05:55:27 GMT-07:00

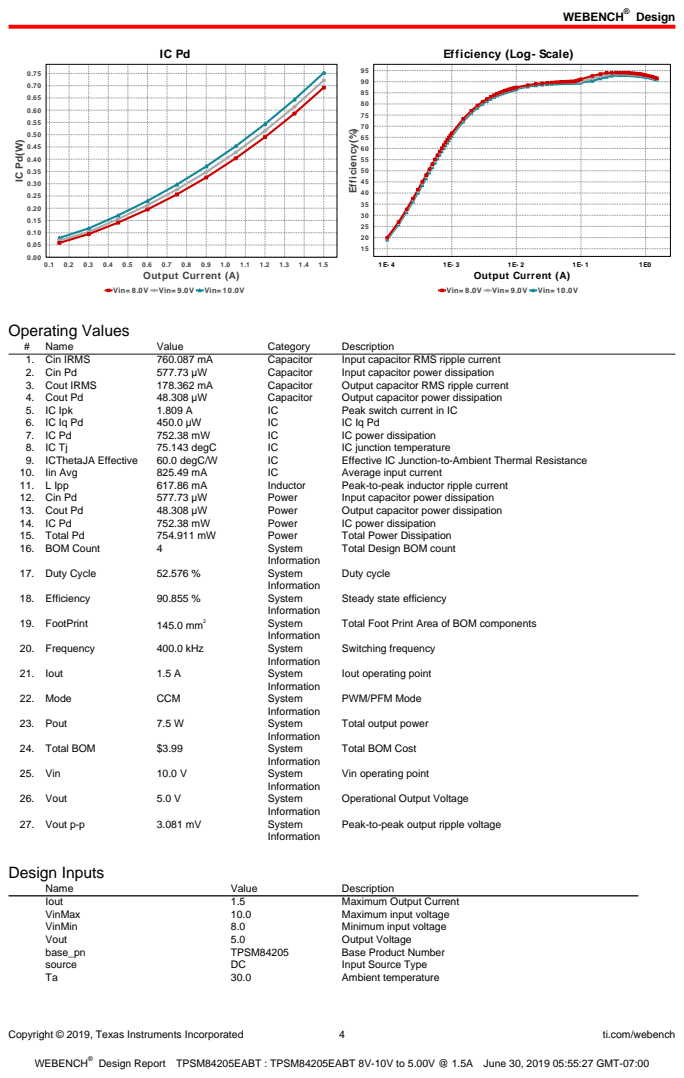
[picture p22: page 23]
WEBENCH®; Design; Copyright © 2019, Texas Instruments Incorporated; ti.com/webench; 1.5 Output Current (A); 1E0 Output Current (A); Efficiency(%); Operating Values; Name; Value; Category; Description; 1. Cin IRMS; Capacitor; Input capacitor RMS ripple current; 2. Cin Pd; Input capacitor power dissipation; 3. Cout IRMS; Output capacitor RMS ripple current; 4. Cout Pd; Output capacitor power dissipation; 5. IC Ipk; Peak switch current in IC; IC power dissipation; 75.143 degC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

Efficiency (Log- Scale)

Vin= 8.0V Vin= 9.0V Vin= 10.0V

Total Design BOM count

Steady state efficiency

Total Foot Print Area of BOM components

Iout operating point

PWM/PFM Mode

Total output power

Total BOM Cost

Vin operating point

Operational Output Voltage

Peak-to-peak output ripple voltage

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

WEBENCH®
Design


Copyright © 2019, Texas Instruments Incorporated | 5 | ti.com/webench

WEBENCH®
Design Report TPSM84205EABT : TPSM84205EABT 8V-10V to 5.00V @ 1.5A June 30, 2019 05:55:27 GMT-07:00

## WEBENCH® Assembly

### Component Testing

Some published data on components in datasheets such as Capacitor ESR and Inductor DC resistance is based on conservative values that will guarantee that the components always exceed the specification. For design purposes it is usually better to work with typical values. Since this data is not always available it is a good practice to measure the Capacitance and ESR values of Cin and Cout, and the inductance and DC resistance of L1 before assembly of the board. Any large discrepancies in values should be electrically simulated in WEBENCH to check for instabilities and thermally simulated in WebTHERM to make sure critical temperatures are not exceeded.

### Soldering Component to Board

If board assembly is done in house it is best to tack down one terminal of a component on the board then solder the other terminal. For surface mount parts with large tabs, such as the DPAK, the tab on the back of the package should be pre-tinned with solder, then tacked into place by one of the pins. To solder the tab town to the board place the iron down on the board while resting against the tab, heating both surfaces simultaneously. Apply light pressure to the top of the plastic case until the solder flows around the part and the part is flush with the PCB. If the solder is not flowing around the board you may need a higher wattage iron (generally 25W to 30W is enough).

### Initial Startup of Circuit

It is best to initially power up the board by setting the input supply voltage to the lowest operating input voltage 8.0V and set the input supply's current limit to zero. With the input supply off connect up the input supply to Vin and GND. Connect a digital volt meter and a load if needed to set the minimum Iout of the design from Vout and GND. Turn on the input supply and slowly turn up the current limit on the input supply. If the voltage starts to rise on the input supply continue increasing the input supply current limit while watching the output voltage. If the current increases on the input supply, but the voltage remains near zero, then there may be a short or a component misplaced on the board. Power down the board and visually inspect for solder bridges and recheck the diode and capacitor polarities. Once the power supply circuit is operational then more extensive testing may include full load testing, transient load and line tests to compare with simulation results.

### Load Testing

The setup is the same as the initial startup, except that an additional digital voltmeter is connected between Vin and GND, a load is connected between Vout and GND and a current meter is connected in series between Vout and the load. The load must be able to handle at least rated output power + 50% ( 7.5 watts for this design). Ideally the load is supplied in the form of a variable load test unit. It can also be done in the form of suitably large power resistors. When using an oscilloscope to measure waveforms on the prototype board, the ground leads of the oscilloscope probes should be as short as possible and the area of the loop formed by the ground lead should be kept to a minimum. This will help reduce ground lead inductance and eliminate EMI noise that is not actually present in the circuit.

## WEBENCH® Electrical Simulation Report

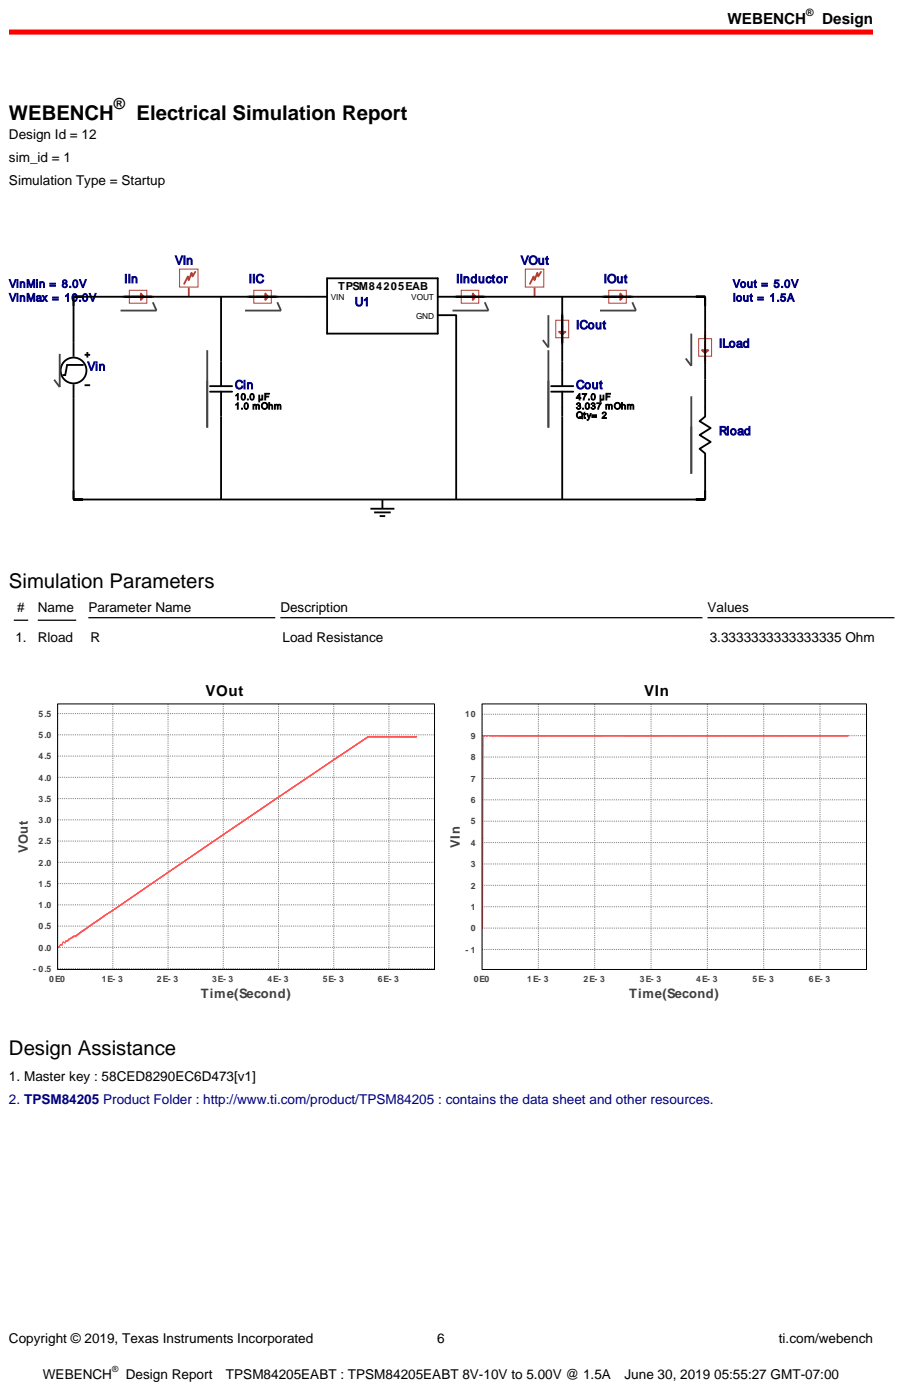
[picture p24: page 25]
WEBENCH®; Design; Copyright © 2019, Texas Instruments Incorporated; ti.com/webench; Cin 10.0 µF 1.0 mOhm; Cout 47.0 µF 3.037 mOhm Qty= 2; ICout; IIn; IIC; IInductor; IOut TPSM84205EAB; VIN; GND; VOUT U1; VinMin = 8.0V VinMax = 10.0V; VIn; Vout = 5.0V Iout = 1.5A; VOut; ILoad; Rload; Vin; Simulation Parameters; # Name Parameter Name; Description; Values; 1. Rload R; Load Resistance; 3.3333333333333335 Ohm; 6E- 3 Time(Second); Design Assistance

Design Id = 12
sim_id = 1
Simulation Type = Startup

1. Master key : 58CED8290EC6D473[v1]
2. TPSM84205 Product Folder : http://www.ti.com/product/TPSM84205 : contains the data sheet and other resources.

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

WEBENCH®
Design
Copyright © 2019, Texas Instruments Incorporated | 7 | ti.com/webench

WEBENCH®
Design Report TPSM84205EABT : TPSM84205EABT 8V-10V to 5.00V @ 1.5A June 30, 2019 05:55:27 GMT-07:00

Important Notice and Disclaimer

TI provides technical and reliability data (including datasheets), design resources (including reference designs), application or other design advice, web tools, safety information, and other resources AS IS and with all faults, and disclaims all warranties. These resources are intended for skilled developers designing with TI products. You are solely responsible for (1) selecting the appropriate TI products for your application, (2) designing, validating and testing your application, and (3) ensuring your application meets applicable standards, and any other safety, security, or other requirements.

These resources are subject to change without notice. TI grants you permission to use these resources only for development of an application that uses the TI products described in the resource. Other reproduction and display of these resources is prohibited. No license is granted to any other TI intellectual property right or to any third party intellectual property right. TI disclaims responsibility for, and you will fully indemnify TI and its representatives against, any claims, damages, costs, losses, and liabilities arising out of your use of these resources.

Providing these resources does not expand or otherwise alter TI's applicable Terms of Sale or other applicable terms available either on ti.com or provided in conjunction with TI products.
