ZjGaothu/Electronic-design/report/final_report/figure/555_mono.pdf

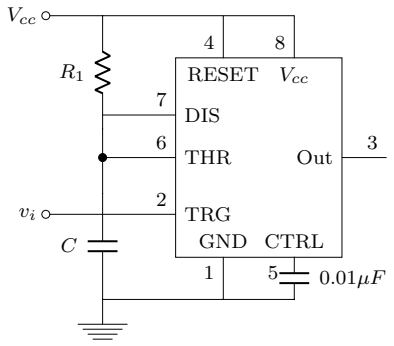
[picture p25: figure]
Vcc; RESET; GND; CTRL; DIS; THR; TRG; Out
