ZjGaothu/Electronic-design/report/final_report/figure/555_osc.pdf

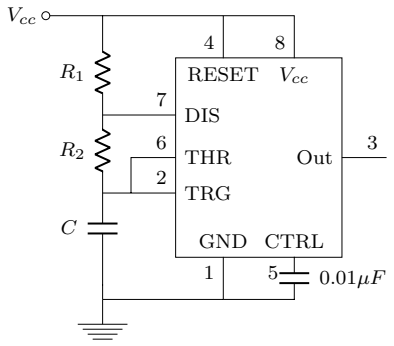
[picture p26: figure]
Vcc; RESET; GND; CTRL; DIS; THR; TRG; Out
