ZjGaothu/Electronic-design/report/final_report/yuxi/yuxi.pdf

# 电子技术设计 环境舒适度综合测量仪 预习报告

班级: 自 72 | 自 72
姓名：高子靖 | 吴文绪
学号: 2017010917 2017010910

目录 | 1

目录

1 选题背景及课题简介 | 1
2 方案比较与选择 | 3
3 基于 WEBENCH 的电源电路仿真 | 7
4 电路框图 | 7
5 数字系统流程图 | 7

## 1 选题背景及课题简介

### 1.1 选题背景

随着城市经济的迅猛发展，我国城市环境大气质量污染程度逐渐增高，尤其在京津冀地区由 于气候、地势以及企业排污不当等原因，其大气污染程度格外严重。而严重的大气污染主要是由 大气中的颗粒污染物所造成，近地面的大气颗粒物会对人们的健康造成直接的危害。 大气细颗粒物代表的是当量直径等于或小于 2.5 微米的颗粒物体，它又被称为细颗粒、细粒、 可入肺颗粒物或是 PM2.5。细微颗粒物易悬浮在空气中，当被人体吸入肺部后易造成健康上的伤 害，会对人的眼睛、鼻腔、上呼吸道等造成直接的伤害。这种细微颗粒物能够进入肺泡且沉积时 间长，可导致心脏病或心血管疾病。因此如何检测大气细微颗粒物从而使得人们能够及时进行健 康上的防护变得格外重要，与实际环境问题结合也是我们与“智能检测”主题相关的出发点。

1 选题背景及课题简介 | 2

### 1.2 课题简介

我们以 PM2.5 检测仪作为出发点，进而加入对空气湿度，温度，气压及其他有害气体的检 测等作为指标，集成为一款环境舒适度综合测量仪，并通过蓝牙模块与手机进行连接，能够传输 一份格式化的环境检测报告到用户的手机中去，以及 LCD 进行显示。

### 1.2.1 测量指标

本课题围绕“智能检测”的主题，拟在设计中加入对以下指标的检测：

- 大气 PM2.5 颗粒浓度
- 空气湿度，也即湿蒸汽中液态水分的质量占蒸汽总质量的百分比
- 环境温度，温度对人体对环境舒适度的感知造成直接的影响
- 大气压强，环境的气压会对人体生理以及心理产生影响

以上我们初步计划进行测量的指标，并对相应的测量数据进行存储与发送。通过以上的四个 指标能够初步反映所处环境的基本状况，包含健康指标和舒适指标，提供给用户后用户可根据相 应的测量结果对湿度，温度等进行调节或做好大气污染的相应防护措施，从而提高环境的舒适 度。

### 1.2.2 实现方法

我们在简介部分只给出实现方案的基本框图，具体的实现方案细节将于第2部分中给出。那 么电路框图如下图 [1] 所示：

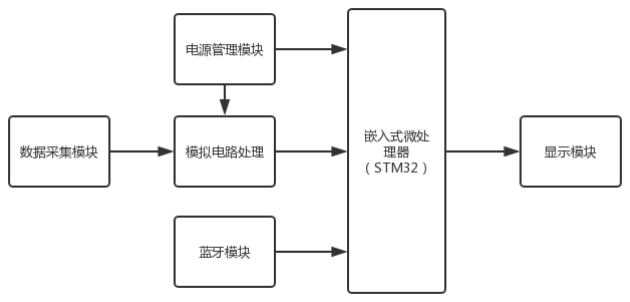
[picture p27: figure]

图 1: 设计总体框图

2 方案比较与选择 | 3

由上图可知，我们通过传感器进行数据采集，进一步进行模拟电路对数据处理，再通过模数 转换电路驱动单片机，除此之外由电源管理模块为单片机以及模拟部分提供稳压电源，并另行有 蓝牙模块与手机进行通讯，而数字部分的处理全部交由 STM32 完成，最终进行显示。

### 1.2.3 结果反馈方法

我们计划使用 LED 或 LCD 显示屏将收集到的数据进行显示，显示内容包括以上叙述的测 量指标，时间日期等，并加入阈值报警，若超过规定的阈值，则通过蜂鸣器进行报警。其次利用 蓝牙模块与手机进行连接，将测量结果可以在用户手机上进行实时的显示，能够极其方便的获取 当前环境情况。

## 2 方案比较与选择

通过我们对文献的查阅以及阅读，可以看到大多数基于单片机的大气环境检测系统，都是选 择一款合适的单片机或其他微处理器作为主控，也即系统的核心，通过各个传感器与主控的连接 进行数据的处理，最后通过 LCD 显示屏来进行结果的反馈。在整体上这些方案大同小异，但为 我们的设计提供了思路与基础，而方案的选择也体现在细节方面的主控芯片的选择以及传感器 的选择。

### 2.1 文献方案叙述

首先叙述总结在文献中获得的方案设计，为了比较不同，我选择了其中的一篇基于 ARM 的 多功能环境检测系统与基于 STC90C51 单片机的多功能检测系统分别进行介绍。

### 2.1.1 基于 ARM 的多功能环境检测系统

首先我查阅到 ARM 处理器是英国 Acorn 有限公司设计的低功耗成本的第一款 RISC 微处 理器。具有体积小、低功耗、低成本、高性能等优势。而在文章¹的设计中以 ARM 作为主控单 元，还包括 PM2.5 传感器单元、温湿度传感器单元、液晶显示屏单元、语音实时播报单元、外 部事件触发单元 [1]。整体可以由如下的框图实现：

1引用文章，见于参考文献 1 中


图 2: ARM 设计总体框图

主控单元与模块化的思路是对于类似系统设计的基本思路，也是我们阅读的文献的共同思 路，而其他传感单元由于可替换性因此需要我们加以选择。
首先主控单元采用了 ARM，可使用 KEIL4 编译软件环境进行开发，同时可利用 C 语言进 行程序的编写，开发时十分方便快捷。
PM2.5 浓度传感器其采用 PMS70XX 系列超薄数字式通用颗粒物浓度传感器。经查阅其中 文手册，得知该传感器工作原理图如下所示：

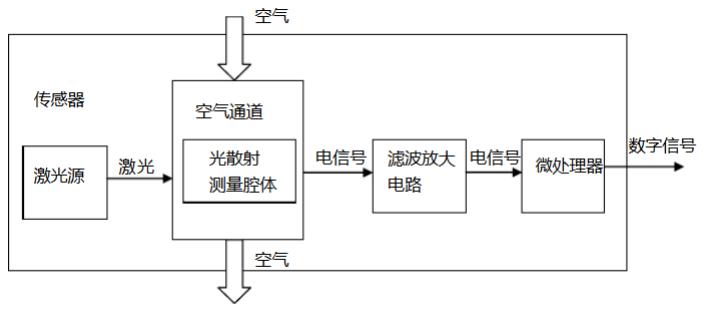
[picture p28: figure]

图 3: PM570XX 系列传感器

其主要通过激光源发射激光经过腔体，在腔体内由于颗粒物浓度不同导致散射光强不同，进 而能够转化为电信号，从而利用反射光强来反馈出细微颗粒物的浓度，直流供电电压为 5V，最 大工作电流为 100mA，工作温度范围为 −20◦C ∼ 50◦C, 传输协议为默认波特率 9600Kbps，无 校验位，有一位停止位。
液晶显示屏采用一个 3.5 英寸的 TFT LCD 液晶屏，320×240 像素，26 万色，支持触摸屏 功能，能够较好的进行显示。其他单元模块芯片不再赘述。

### 2.1.2 基于 STC90C51 的检测系统

该检测系统为我所阅读文献中另一篇较具有代表性的文献，其设计除主控单元不同外，在传 感器的选取上也与上一个单元有所不同，因此特此拿来与上一个系统进行比较分析，同样首先从 整体框图上说明该系统的工作原理。


图 4: STC90C51 总体框图

可见该系统总体框图与 ARM 系统基本相似，均以单片机作为主控单元，各模块电路通过硬 件连接与主控单元进行相连与交互，只是该系统的设计中外接部分单元电路的功能不同。 其主控单元为 STC90C51 单片机，为一款高速低功耗单片机，其在编译环境以及编程的方 便性与可移植性等方面与其他单片机并无较大差别，因此也非选择的重点。
其 PM2.5 检测模块使用的传感器为 GP2Y1050AU0F 灰尘传感器，是夏普公司开发的二代 PM2. 5 传感器 [3]，输出电压在 0 ∼ 3.5V 的范围内，电流损耗最大为 20mA。在无尘时输出电 压为 0V，其原理如下图 [5] 所示：

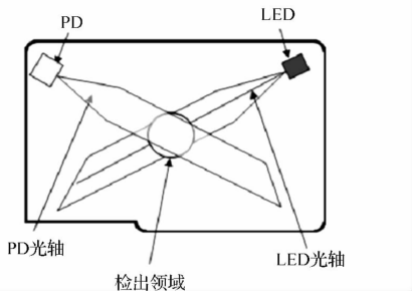
[picture p29: figure]

图 5: GP2Y1050AU0F 灰尘传感器结构

检测原理为灰尘或烟雾颗粒通过防尘通气孔进入装置，红外发光二极管发射红外线到颗粒 物上，光敏三极管接收其散射光信号。可见其原理与 PM570XX 系列相似，第二代 PM2. 5 传感 器能随使用时间的增长自动计算和优化损耗 [2]，能够在较长时间的使用后保证输出数据的准确 性，相对而言体现了此传感器的优势。
在此设计中采用 ADS7822 进行模数转换，其输入与传感器的模拟输出相连, 作用是将传感 器输出的模拟电压信号经过 A/D 转换，再由单片机数据采集、计算、处理。ADS7822 是 TI 公

司的低功耗，高性能 12 位 A/D 转换芯片，正常模式下典型功耗为 0.54mW。 其使用的温度模块采用了 DS18B20 数字温度传感器，其具 9 Bit 至 12Bit 的摄氏温度测量 精度，测量范围为-55∼ +125◦C, 可以直接由数据线进行供电而不需要外部电源，因此可以外部 电源的使用。
综上所述介绍的两种具有多功能的 PM2.5 检测仪，为我们的设计提供了基本的思路与选择 的方向，我们旨在设计出具有更多功能的环境舒适度测量仪，以上 pm2.5 的多功能模块的总体 方案为我们的设计的重要部分，接下来我将继续介绍我们的整体方案选择。

### 2.2 方案选择

综合考虑我们选用 Arduino 单片机作为主控模块，其余相应单元模块进行了芯片的初步选 择，这既考虑到芯片供电电压的选取与我们电源管理电路模块尽量相符，又兼并考虑了芯片的精 度，工作范围等条件，下面依次介绍我们所选取的芯片，电路框图类比于以上两种设计，我们的 设计如下：

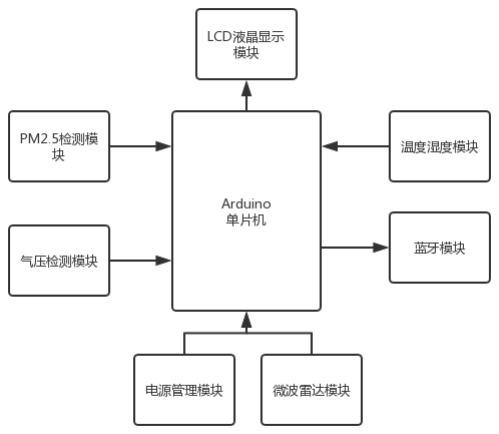
[picture p30: figure]

图 6: 简略框图

3 基于 WEBENCH 的电源电路仿真 | 7

### 2.2.1 单片机 Arduino

### 2.2.2 GP2Y1050AU0F 灰尘传感器

### 2.2.3 DHT-11 温度湿度传感器

### 2.2.4 LCD1602 液晶显示屏

### 2.2.5 TTP226 电容触摸开关

## 3 基于 WEBENCH 的电源电路仿真

## 4 电路框图

## 5 数字系统流程图

## 参考文献

[1] 曲爱玲 and 马长路. 基于 arm 的多功能环境检测系统. 仪表技术与传感器, (9):91–93, 2017.
[2] 王路, 曲伟, and 胡家骏. 多功能 pm2.5 检测系统. 黑龙江大学工程学报, 7(1):66–72, 2016.
[3] 陈卓. 一种 pm2.5 检测系统的设计与实现. 数字技术与应用, (11):143–144, 2016.
