ZjGaothu/Electronic-design/report/final_report/figure/vcvs.pdf

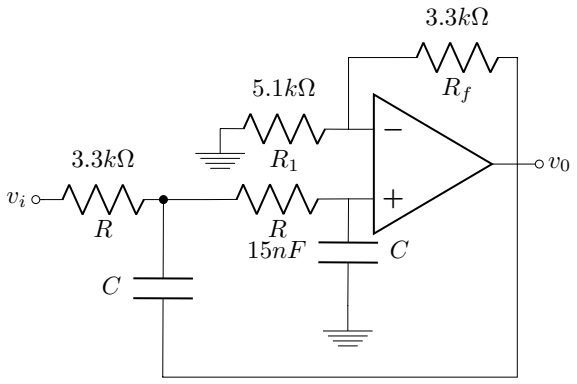
[picture p95: figure]
