ZjGaothu/Electronic-design/datasheet/Arduino_uno_pin.jpg

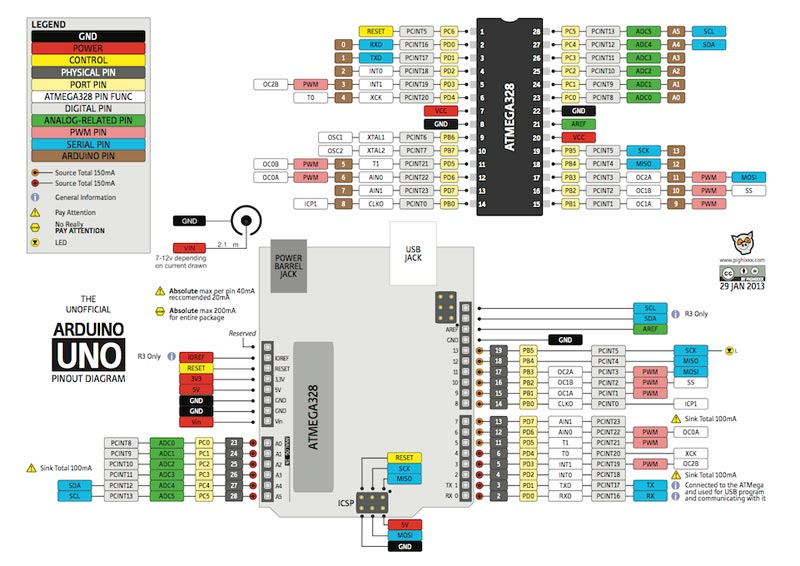
datasheet/Arduino_uno_pin.jpg
