ZjGaothu/Electronic-design/datasheet/GP2Y1050.png

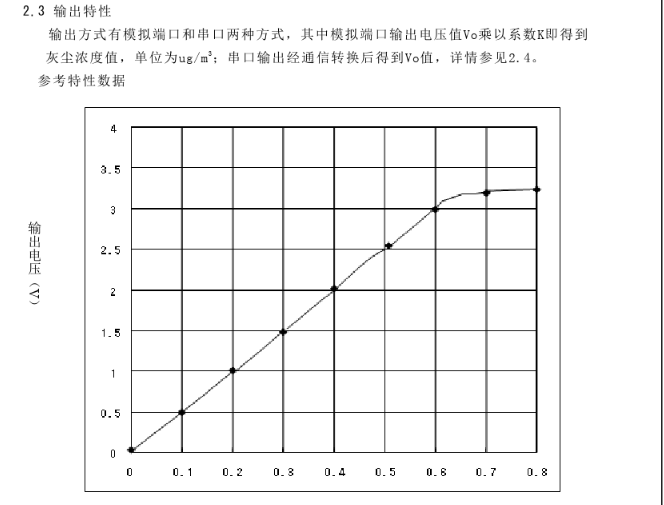
datasheet/GP2Y1050.png
