ZjGaothu/Electronic-design/datasheet/GP2Y1050_table.png

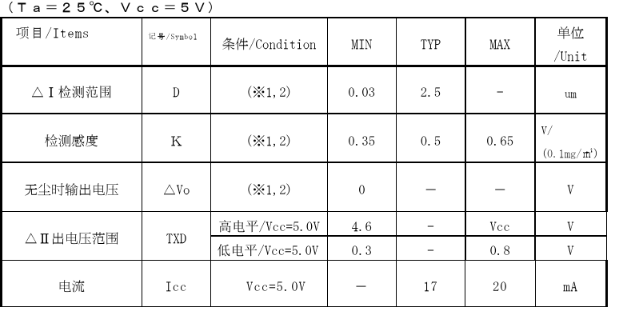
datasheet/GP2Y1050_table.png
