ZjGaothu/Electronic-design/datasheet/I2C_time_sequence.jpg

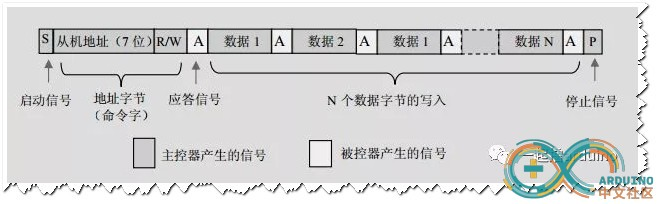
datasheet/I2C_time_sequence.jpg
