ZjGaothu/Electronic-design/datasheet/LCD_I2C_PCF8547.png

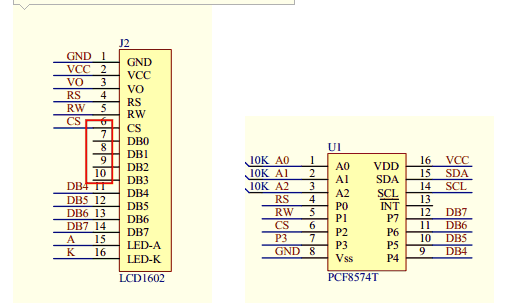
datasheet/LCD_I2C_PCF8547.png
