ZjGaothu/Electronic-design/gzj_temp/lcd12864/连线.jpg

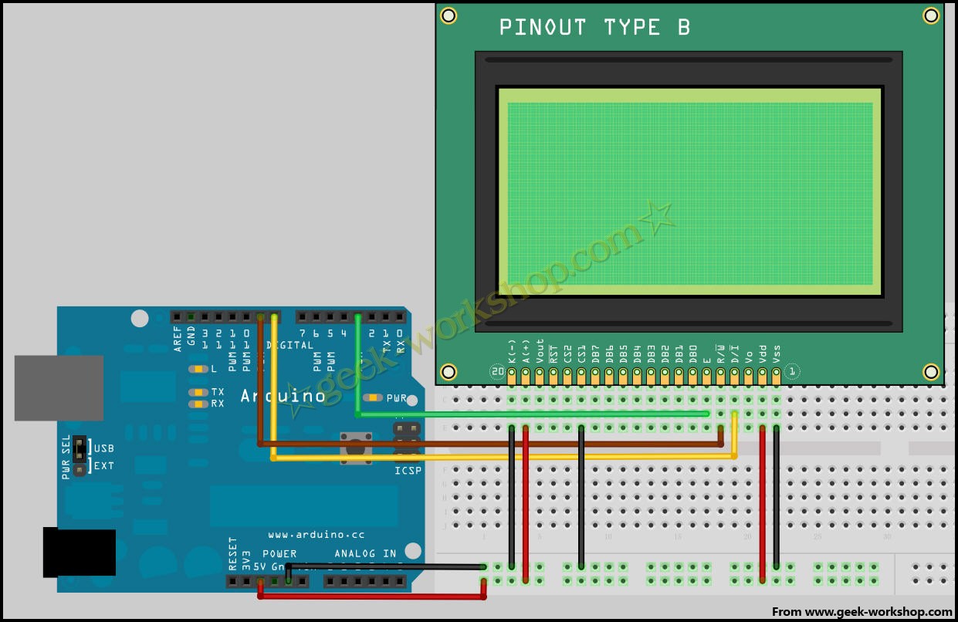
gzj_temp/lcd12864/连线.jpg
