ZjGaothu/Electronic-design/report/final_report/figure/1-1.png

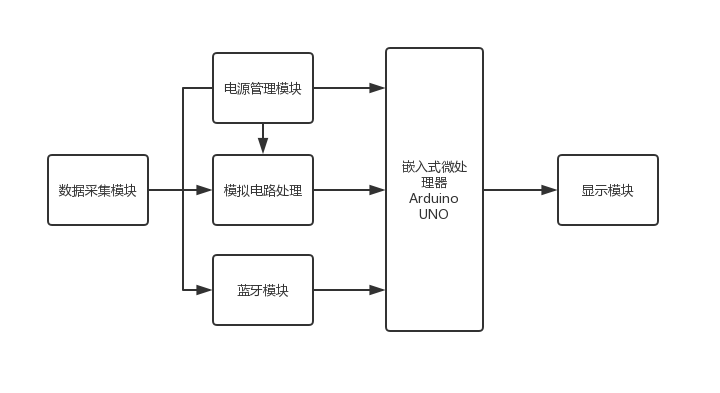
report/final_report/figure/1-1.png
