ZjGaothu/Electronic-design/report/final_report/figure/1-n.png

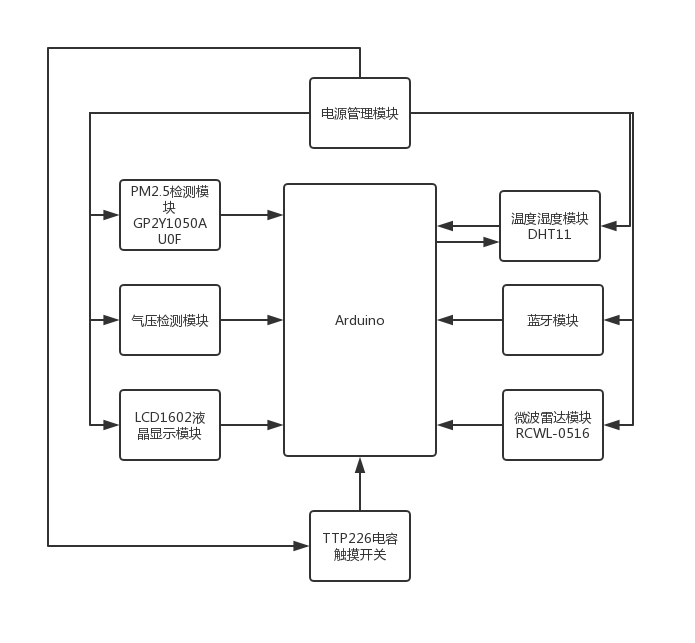
report/final_report/figure/1-n.png
