ZjGaothu/Electronic-design/report/final_report/figure/dianyuan2.png

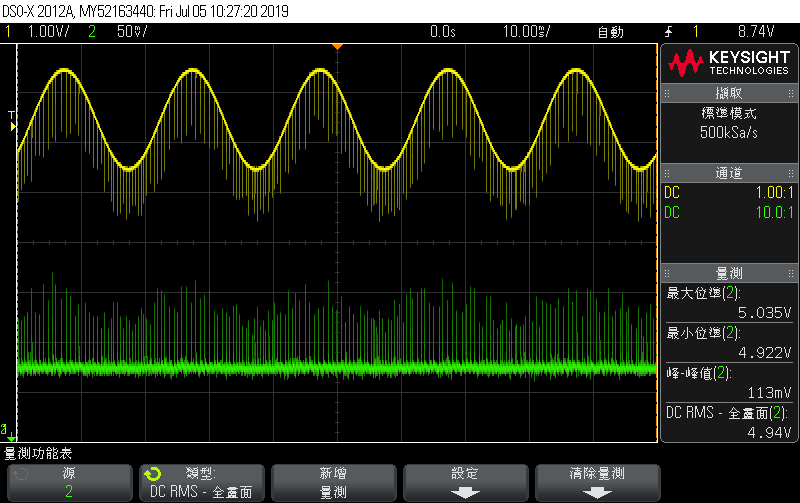
report/final_report/figure/dianyuan2.png
