ZjGaothu/Electronic-design/report/final_report/figure/dy.jpg

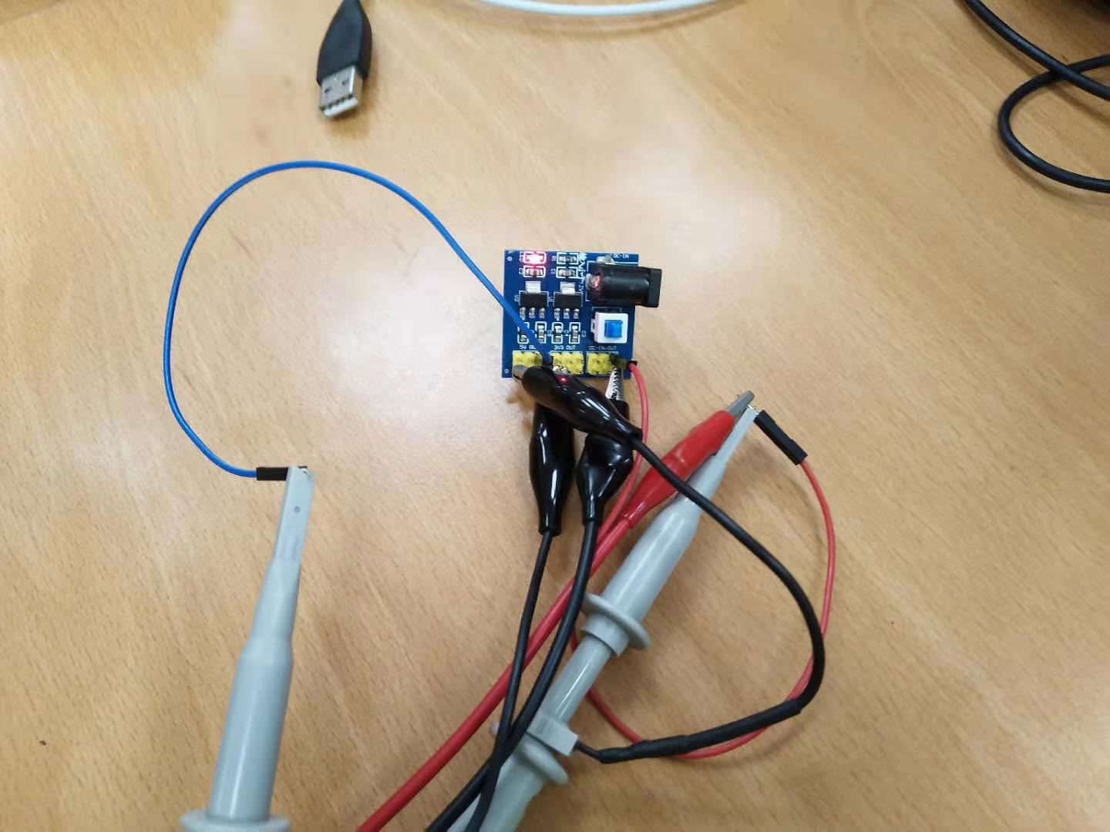
report/final_report/figure/dy.jpg
