ZjGaothu/Electronic-design/report/final_report/yuxi/figure/1-1.png

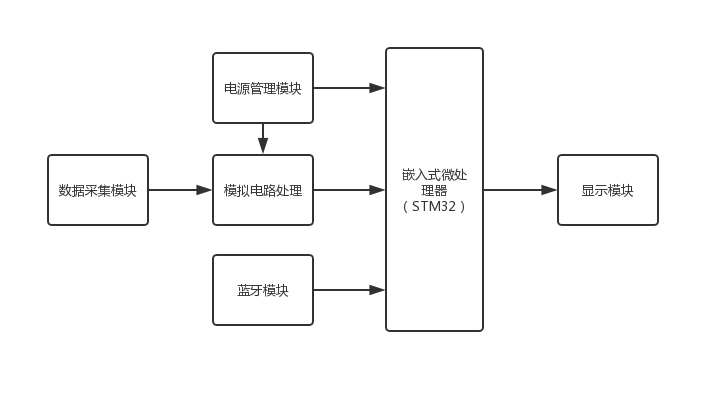
report/final_report/yuxi/figure/1-1.png
