ZjGaothu/Electronic-design/report/final_report/yuxi/figure/1-n.png

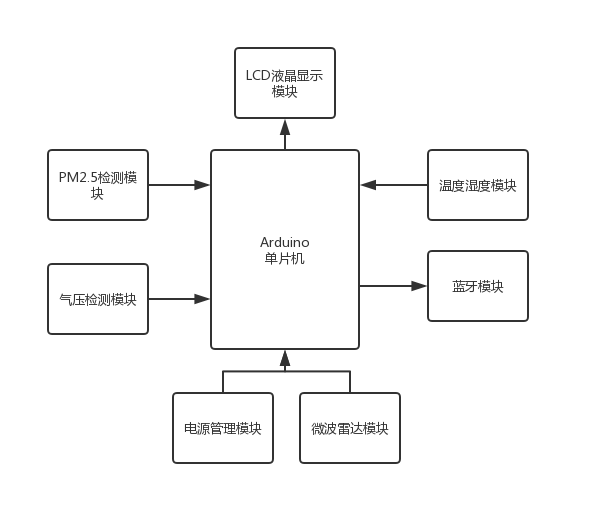
report/final_report/yuxi/figure/1-n.png
