ZjGaothu/Electronic-design/gzj_temp/GP2Y_test/connecting2.png

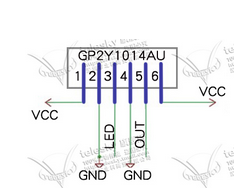
gzj_temp/GP2Y_test/connecting2.png
