ZjGaothu/Electronic-design/gzj_temp/GP2Y_test/connecting.png

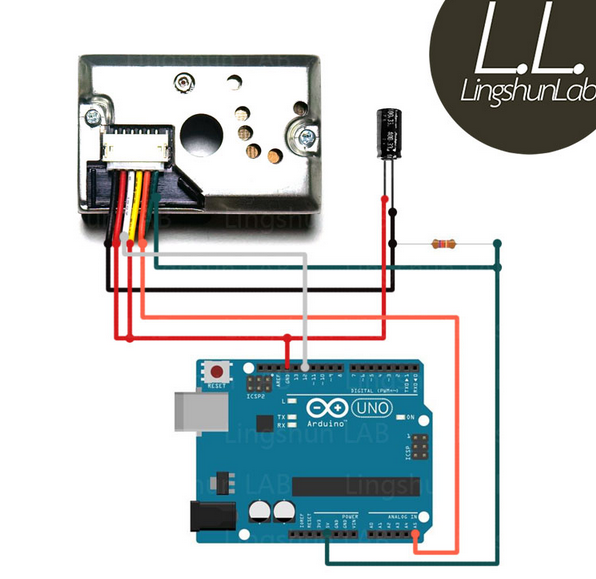
gzj_temp/GP2Y_test/connecting.png
