ZjGaothu/Electronic-design/(list of files, drawings)

Other design files:
gzj_temp/CHAO.ms14
gzj_temp/lcd12864/低通.ms14
wwx_temp/intr_src.ms14
wwx_temp/light_555.ms14
wwx_temp/low_power_chaos.ms14
