ZjGaothu/Electronic-design/report/final_report/dht11.cpp

#include "dht11.h"

// Return values:
// DHTLIB_OK
// DHTLIB_ERROR_CHECKSUM
// DHTLIB_ERROR_TIMEOUT
int dht11::read(int pin)
{
	// BUFFER TO RECEIVE
	uint8_t bits[5];
	uint8_t cnt = 7;
	uint8_t idx = 0;

	// EMPTY BUFFER
	for (int i=0; i< 5; i++) bits[i] = 0;

	// REQUEST SAMPLE
	pinMode(pin, OUTPUT);
	digitalWrite(pin, LOW);
	delay(18);
	digitalWrite(pin, HIGH);
	delayMicroseconds(40);
	pinMode(pin, INPUT);

	// ACKNOWLEDGE or TIMEOUT
	unsigned int loopCnt = 10000;
	while(digitalRead(pin) == LOW)
		if (loopCnt-- == 0) return DHTLIB_ERROR_TIMEOUT;

	loopCnt = 10000;
	while(digitalRead(pin) == HIGH)
		if (loopCnt-- == 0) return DHTLIB_ERROR_TIMEOUT;
  uint8_t sum = 0;
	// READ OUTPUT - 40 BITS => 5 BYTES or TIMEOUT
	for (int i=0; i<40; i++)
	{
		loopCnt = 10000;
		while(digitalRead(pin) == LOW)
			if (loopCnt-- == 0) return DHTLIB_ERROR_TIMEOUT;

		unsigned long t = micros();

		loopCnt = 10000;
		while(digitalRead(pin) == HIGH)
			if (loopCnt-- == 0) return DHTLIB_ERROR_TIMEOUT;
		if ((micros() - t) > 40) {bits[idx] |= (1 << cnt);}
		if (cnt == 0)   // next byte?
		{
			cnt = 7;    // restart at MSB
    //   if (idx != 4) {
    //     sum += bits[idx];
    //   }
			idx++;      // next byte!
		}
		else cnt--;
	}

  humidity_int = bits[0];
  humidity_dec = bits[1];
  temperature_int = bits[2];
  temperature_dec = bits[4];


	if (bits[4] != sum) return DHTLIB_ERROR_CHECKSUM;
	return DHTLIB_OK;
}
//
// END OF FILE
//
