ZjGaothu/Electronic-design/gzj_temp/Serial_lcd/serial_LCD1/serial_lcd.cpp

// Based on the work by DFRobot

#include "serial_lcd.h"
#include <inttypes.h>
#if defined(ARDUINO) && ARDUINO >= 100

#include "Arduino.h"

#define printIIC(args)	Wire.write(args)
inline size_t serial_lcd::write(uint8_t value) {
	send(value, Rs);
	return 1;
}

#else
#include "WProgram.h"

#define printIIC(args)	Wire.send(args)
inline void serial_lcd::write(uint8_t value) {
	send(value, Rs);
}

#endif
#include "Wire.h"

serial_lcd::serial_lcd(uint8_t lcd_Addr,uint8_t lcd_cols,uint8_t lcd_rows)
{
  _Addr = lcd_Addr;
  _cols = lcd_cols;
  _rows = lcd_rows;
  _backlightval = LCD_NOBACKLIGHT;
}

void serial_lcd::init(){
	init_priv();
}

void serial_lcd::oled_init(){
  _oled = true;
	init_priv();
}
void serial_lcd::display() {
	_displaycontrol |= LCD_DISPLAYON;
	command(LCD_DISPLAYCONTROL | _displaycontrol);
}

void serial_lcd::begin(uint8_t cols, uint8_t lines, uint8_t dotsize) {
	if (lines > 1) {
		_displayfunction |= LCD_2LINE;
	}
	_numlines = lines;

	// for some 1 line displays you can select a 10 pixel high font
	if ((dotsize != 0) && (lines == 1)) {
		_displayfunction |= LCD_5x10DOTS;
	}

	// SEE PAGE 45/46 FOR INITIALIZATION SPECIFICATION!
	// according to datasheet, we need at least 40ms after power rises above 2.7V
	// before sending commands. Arduino can turn on way befer 4.5V so we'll wait 50
	delay(50); 
  
	// Now we pull both RS and R/W low to begin commands
	expanderWrite(_backlightval);	// reset expanderand turn backlight off (Bit 8 =1)
	delay(1000);

  	//put the LCD into 4 bit mode
	// this is according to the hitachi HD44780 datasheet
	// figure 24, pg 46
	
	  // we start in 8bit mode, try to set 4 bit mode
   write4bits(0x03 << 4);
   delayMicroseconds(4500); // wait min 4.1ms
   
   // second try
   write4bits(0x03 << 4);
   delayMicroseconds(4500); // wait min 4.1ms
   
   // third go!
   write4bits(0x03 << 4); 
   delayMicroseconds(150);
   
   // finally, set to 4-bit interface
   write4bits(0x02 << 4); 


	// set # lines, font size, etc.
	command(LCD_FUNCTIONSET | _displayfunction);  
	
	// turn the display on with no cursor or blinking default
	_displaycontrol = LCD_DISPLAYON | LCD_CURSOROFF | LCD_BLINKOFF;
	display();
	
	// clear it off
	clear();
	_displaymode = LCD_ENTRYLEFT | LCD_ENTRYSHIFTDECREMENT;
	
	command(LCD_ENTRYMODESET | _displaymode);
	
	home();
  
}

void serial_lcd::clear(){    //屏幕清理
	command(LCD_CLEARDISPLAY);// clear display, set cursor position to zero
	delayMicroseconds(2000);
  if (_oled) setCursor(0,0);   //发光时重新设置光标
}

void serial_lcd::home(){
	command(LCD_RETURNHOME);  // set cursor position to zero
	delayMicroseconds(2000);  // this command takes a long time!
}
//设置光标位置
void serial_lcd::setCursor(uint8_t col, uint8_t row){
	int row_offsets[] = { 0x00, 0x40, 0x14, 0x54 };
	if ( row > _numlines ) {
		row = _numlines-1;    
	}
	command(LCD_SETDDRAMADDR | (col + row_offsets[row]));
}

//是否显示光标
void serial_lcd::noCursor() {
	_displaycontrol &= ~LCD_CURSORON;
	command(LCD_DISPLAYCONTROL | _displaycontrol);
}
void serial_lcd::cursor() {
	_displaycontrol |= LCD_CURSORON;
	command(LCD_DISPLAYCONTROL | _displaycontrol);
}

//控制背景灯是否亮
void serial_lcd::noBacklight(void) {
	_backlightval=LCD_NOBACKLIGHT;
	expanderWrite(0);
}

void serial_lcd::backlight(void) {
	_backlightval=LCD_BACKLIGHT;
	expanderWrite(0);
}


inline void serial_lcd::command(uint8_t value) {
	send(value, 0);
}


//写命令或者数据
void serial_lcd::send(uint8_t value, uint8_t mode) {
	uint8_t highnib=value&0xf0;
	uint8_t lownib=(value<<4)&0xf0;
    write4bits((highnib)|mode);
	write4bits((lownib)|mode); 
}

void serial_lcd::write4bits(uint8_t value) {
	expanderWrite(value);
	pulseEnable(value);
}

void serial_lcd::expanderWrite(uint8_t _data){                                        
	Wire.beginTransmission(_Addr);
	printIIC((int)(_data) | _backlightval);
	Wire.endTransmission();   
}

void serial_lcd::pulseEnable(uint8_t _data){
	expanderWrite(_data | En);	// En high
	delayMicroseconds(1);		// enable pulse must be >450ns
	
	expanderWrite(_data & ~En);	// En low
	delayMicroseconds(50);		
} 
void serial_lcd::init_priv()
{
	Wire.begin();
	_displayfunction = LCD_4BITMODE | LCD_1LINE | LCD_5x8DOTS;
	begin(_cols, _rows);  
}
