ZjGaothu/Electronic-design/gzj_temp/main/dht11.h

#ifndef dht11_h
#define dht11_h

#if defined(ARDUINO) && (ARDUINO >= 100)
#include <Arduino.h>
#else
#include <WProgram.h>
#endif

#define DHT11LIB_VERSION "0.4.1"

#define DHTLIB_OK				0
#define DHTLIB_ERROR_CHECKSUM	-1
#define DHTLIB_ERROR_TIMEOUT	-2

class dht11
{
public:
    int read(int pin);
	int humidity;
	int temperature;
};
#endif
//
// END OF FILE
//
