ZjGaothu/Electronic-design/(commit log)

2019-07-02 温湿度模块调试
2019-07-02 气压检测
2019-07-03 SD module test, and add pin configure in comment
2019-07-03 IR remote SD card servo
2019-07-03 7.3afternoon_log I2C data and controller code
2019-07-04 init 7.4
    [低通.ms14]
2019-07-04 I2C know!!!, IO to I2C work
2019-07-05 7.5 afternoon log
    [light_555.ms14]
2019-07-07 first joint release, can loop measure and show
2019-07-07 1.1 joint release, add ir bluetooth sd write
2019-07-08 joint_1.2 fix LCD roll, TODO PM2.5 no data
    [intr_src.ms14]
2019-07-08 Env 1.3, IR, PM2.5, work
    [low_power_chaos.ms14]
2019-07-10 7.10 log
    [recorder.csv]
2019-07-14 final_report v1.0
    [recorder.csv]
